Neuropribor/wec/README.md

# wec
An open-source Wireless Electrophysological Complex
