Neuropribor/wec/software/source_code_for_MouseBrainView-v0.2.3/README_rus.md

# Project 45340

## GUI
Клиент с графическим интерфейсом находится в папке GUI.  
Для его сборки необходимо следующее ПО:  
- Python 3.7
- библиотека PyQt5 5.12.3
- библиотека PyQtGraph 0.11.1
- библиотека numpy 1.19.5
- pyinstaller 4.2
- pyrcc5 5.12.3
  
Для запуска программы нужно перейти в папку "build" и выполнить команду
```
make run
```
Для сборки бинарного файла просто выполнить команду
```
make
```
Команда "make" без "run" соберёт статический бинарный файл, который можно в будущем запустить на другом компьютере без рабочего окружения.  

По-умолчанию в makefile используется команда "python3" для запуска python3 и команда "pyrcc5" для запуска pyrcc5.  
Если в вашем рабочем окружении ключевые слова для вызова этих программ отличаются, можно задать другие ключевые слова для python3 и pyrcc5 при помощи переменных среды PP3 и RCC5 соответственно.  
Пример:
```
C:\msys64\usr\bin\make PP3=python RCC5=C:\Users\owner\anaconda3\Library\bin\pyrcc5.bat run
```
