Neuropribor/wec/BOM/base_station/base_station.xls

Comment | Designator | Footprint | LCSC
KH-5220-A56 | AE1 | 5.2x2.0mm | C504003
CL10A105KB8NNNC | C14,C19,C35 | Capacitor_SMD:C_0603_1608Metric | C15849
CL10A225KO8NNNC | C21,C23 | Capacitor_SMD:C_0603_1608Metric | C23630
1206B103K202NT | C3,C4 | Capacitor_SMD:C_1206_3216Metric | C53737
CL10B333KB8NNNC | C30 | Capacitor_SMD:C_0603_1608Metric | C21117
CL10B102KB8NNNC | C31 | Capacitor_SMD:C_0603_1608Metric | C1588
0603B103K500NT | C33 | Capacitor_SMD:C_0603_1608Metric | C57112
0603B222K500NT | C36 | Capacitor_SMD:C_0603_1608Metric | C1604
0603CG1R5C500NT | C37 | Capacitor_SMD:C_0603_1608Metric | C1639
0603CG4R7C500NT | C38 | Capacitor_SMD:C_0603_1608Metric | C1669
CL10C010CB8NNNC | C39 | Capacitor_SMD:C_0603_1608Metric | C23969
CC0603KRX7R9BB104 | C1,C2,C5,C6,C7,C8,C10,C12,C13,C15,C16,C17,C20,C24,C25,C26,C27,C28,C29 | Capacitor_SMD:C_0603_1608Metric | C14663
CL10C220JB8NNNC | C9,C11,C18,C22,C32,C34 | Capacitor_SMD:C_0603_1608Metric | C1653
DM9162EP | D1 | Package_QFP:LQFP-48_7x7mm_P0.5mm | C692729
LY68L6400 | D2 | Package_SO:SO-8_3.9x4.9mm_P1.27mm | C261881
SDCL1608C8N2JTDF | L1 | Inductor_SMD:L_0603_1608Metric | C1032
SDCL1608C3N9STDF | L2 | Inductor_SMD:L_0603_1608Metric | C13818
SDCL1608C2N7STDF | L3 | Inductor_SMD:L_0603_1608Metric | C13817
0603WAF1002T5E | R1,R2,R10,R12,R13,R14,R19,R20,R27,R29,R31 | Resistor_SMD:R_0603_1608Metric | C25804
0603WAF6801T5E | R11 | Resistor_SMD:R_0603_1608Metric | C23212
0603WAF3000T5E | R15,R16,R23,R24,R25,R26,R28,R30,R32,R33,R34 | Resistor_SMD:R_0603_1608Metric | C23025
0603WAF5101T5E | R17,R18 | Resistor_SMD:R_0603_1608Metric | C23186
0603WAF2202T5E | R21 | Resistor_SMD:R_0603_1608Metric | C31850
0603WAF1004T5E | R22 | Resistor_SMD:R_0603_1608Metric | C22935
0603WAF4701T5E | R35,R36,R37 | Resistor_SMD:R_0603_1608Metric | C23162
0603WAF5100T5E | R3,R4 | Resistor_SMD:R_0603_1608Metric | C23193
0603WAF510JT5E | R5,R6,R7,R8 | Resistor_SMD:R_0603_1608Metric | C23197
0603WAF0000T5E | R9 | Resistor_SMD:R_0603_1608Metric | C21189
AMS1117-3.3 | U1 | Package_TO_SOT_SMD:SOT-223-3_TabPin2 | C6186
SST25VF040B-50-4I-S2AF | U2 | Package_SO:SOIC-8_5.275x5.275mm_P1.27mm | C178274
STM32F746VET6 | U3 | Package_QFP:LQFP-100_14x14mm_P0.5mm | C117505
NRF24L01P-R | U4 | Package_DFN_QFN:QFN-20-1EP_4x4mm_P0.5mm_EP2.5x2.5mm | C8791
TLP172GM | U5,U6,U7 | Package_SO:MFSOP6-4_4.4x3.6mm_P1.27mm | C261926
TP4054 | U8,U9,U10 | Package_TO_SOT_SMD:TSOT-23-5 | C32574
X322525MOB4SI | Y1 | Crystal:Crystal_SMD_3225-4Pin_3.2x2.5mm | C9006
X322516MLB4SI | Y2,Y3 | Crystal:Crystal_SMD_3225-4Pin_3.2x2.5mm | C13738
