Neuropribor/wec/BOM/wireless_module/wireless_module_BOM.xls

Comment | Designator | Footprint | LCSC | Contacts
KH-5220-A56 | AE1 | Resistor_SMD:R_2010_5025Metric_Pad1.52x2.65mm_HandSolder | C504003 | https://lcsc.com/
0402CG4R7C500NT | C10 | Capacitor_SMD:C_0402_1005Metric | C1569 | https://lcsc.com/
0402CG1R0C500NT | C11 | Capacitor_SMD:C_0402_1005Metric | C1550 | https://lcsc.com/
CL05B104KO5NNNC | C14 | Capacitor_SMD:C_0402_1005Metric | C1525 | https://lcsc.com/
CL05A105KA5NQNC | C2,C13 | Capacitor_SMD:C_0402_1005Metric | C52923 | https://lcsc.com/
CL05B103KB5NNNC | C3,C15 | Capacitor_SMD:C_0402_1005Metric | C15195 | https://lcsc.com/
0402B102K500NT | C1,C4,C12 | Capacitor_SMD:C_0402_1005Metric | C1523 | https://lcsc.com/
0402F333M500NT | C5 | Capacitor_SMD:C_0402_1005Metric | C1585 | https://lcsc.com/
0402CG220J500NT | C6,C7 | Capacitor_SMD:C_0402_1005Metric | C1555 | https://lcsc.com/
0402B222K500NT | C8 | Capacitor_SMD:C_0402_1005Metric | C1531 | https://lcsc.com/
0402CG1R5C500NT | C9 | Capacitor_SMD:C_0402_1005Metric | C1552 | https://lcsc.com/
RHD2132 | D1 | Package_DFN_QFN:QFN-56-1EP_8x8mm_P0.5mm_EP4.5x5.2mm |  | http://intantech.com/products_RHD2000.html
STM32G071GBU6 | D2 | STM32F031G4U6:QFN50P400X400X60-28N | C529347 | https://lcsc.com/
FC-F1005YGK-572J5 | D3 | LED_SMD:LED_0402_1005Metric | C130722 | https://lcsc.com/
A79027-001 | J1 | main_block:A79027-001 |  | https://www.cseonline.com.au/A79027-001.html
A79607-001 | J5 | main_block:A79607-001 |  | https://www.cseonline.com.au/A79607-001.html
SDCL1005C8N2JTDF | L1 | Inductor_SMD:L_0402_1005Metric | C16208 | https://lcsc.com/
SDCL1005C3N9STDF | L2 | Inductor_SMD:L_0402_1005Metric | C14033 | https://lcsc.com/
SDCL1005C2N7STDF | L3 | Inductor_SMD:L_0402_1005Metric | C27123 | https://lcsc.com/
0402WGF1002TCE | R1 | Resistor_SMD:R_0402_1005Metric | C25744 | https://lcsc.com/
0402WGF2202TCE | R2 | Resistor_SMD:R_0402_1005Metric | C25768 | https://lcsc.com/
0402WGF1004TCE | R3 | Resistor_SMD:R_0402_1005Metric | C26083 | https://lcsc.com/
0402WGF3300TCE | R4,R5,R6,R7 | Resistor_SMD:R_0402_1005Metric | C25104 | https://lcsc.com/
KTH1601SL-ST3 | U1 | Package_TO_SOT_SMD:SOT-23 | C516265 | https://lcsc.com/
TLV70033DSER | U2,U3 | Package_SON:WSON-6_1.5x1.5mm_P0.5mm | C97256 | https://lcsc.com/
nRF24L01P | U4 | Package_DFN_QFN:QFN-20-1EP_4x4mm_P0.5mm_EP2.5x2.5mm | C8791 | https://lcsc.com/
7F16000E12UCG | Y1 | Crystal:Crystal_SMD_2016-4Pin_2.0x1.6mm | C252270 | https://lcsc.com/
