Neuropribor/wec/firmware/source_code_for_firmware_STM32CubeIDE/wireless_module/main_block/step/dg_main_block.step

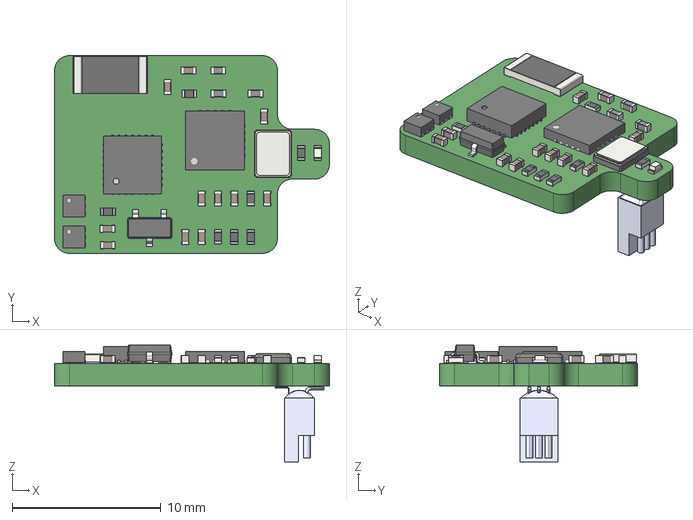
[picture p1: CAD file, 2021-10-13]
firmware/source_code_for_firmware_STM32CubeIDE/wireless_module/main_block/step/dg_main_block.step
18.5 x 13.3 x 7.87 mm
