Neuropribor/wec/3d_models/base_chargin_station/wireless_module_mount_X3.STL

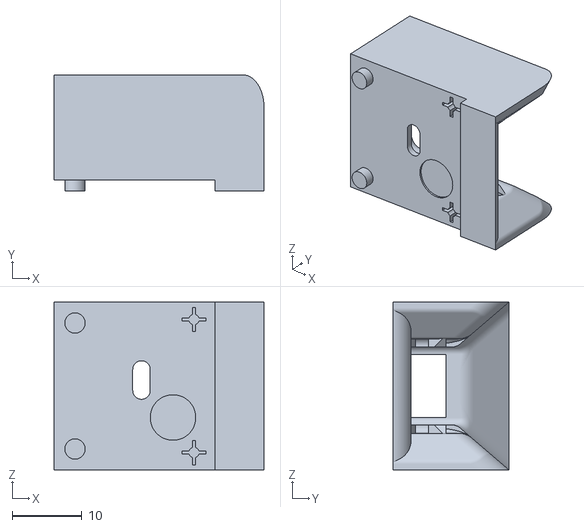
[picture p2: CAD file, 2021-10-13]
3d_models/base_chargin_station/wireless_module_mount_X3.STL
30.0 x 16.6 x 24.0
