Neuropribor/wec/3d_models/wireless_module_clip/bottom.STL

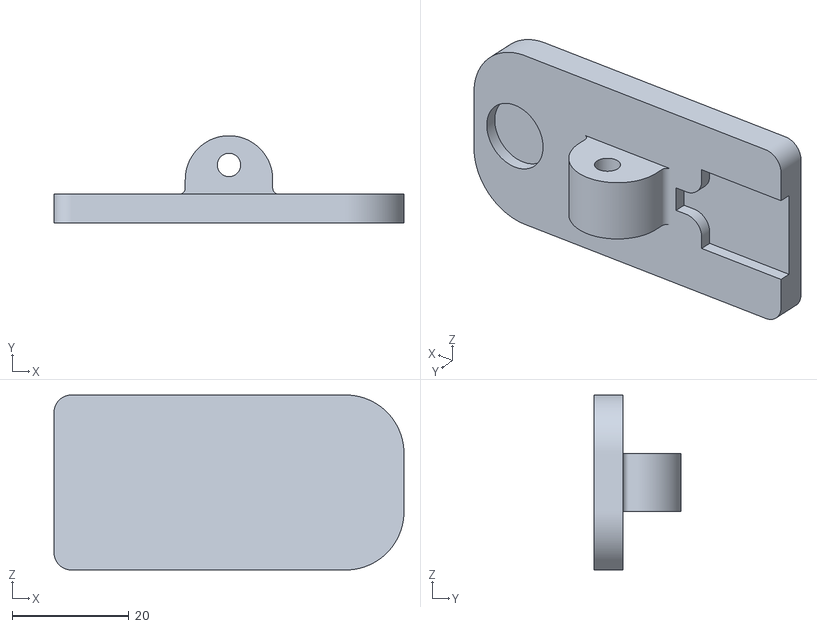
[picture p3: CAD file, 2021-10-13]
3d_models/wireless_module_clip/bottom.STL
60.0 x 15.0 x 30.0
