Neuropribor/wec/3d_models/base_chargin_station/bottom_cover.STL

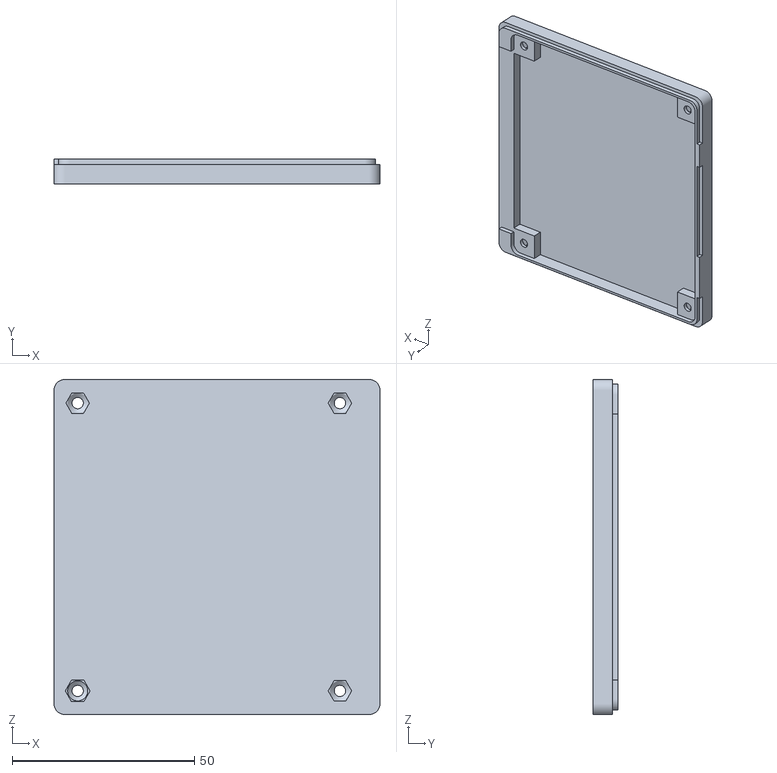
[picture p4: CAD file, 2021-10-13]
3d_models/base_chargin_station/bottom_cover.STL
89.5 x 7.00 x 92.0
