Neuropribor/wec/3d_models/wireless_module_clip/top.STL

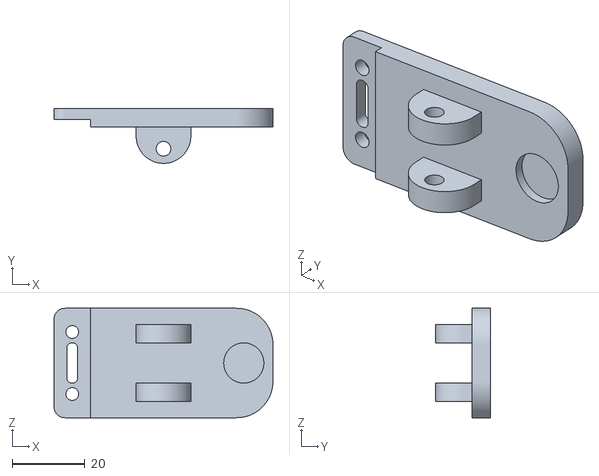
[picture p5: CAD file, 2021-10-13]
3d_models/wireless_module_clip/top.STL
60.0 x 15.0 x 30.0
