Neuropribor/wec/3d_models/base_chargin_station/LED_holder.STL

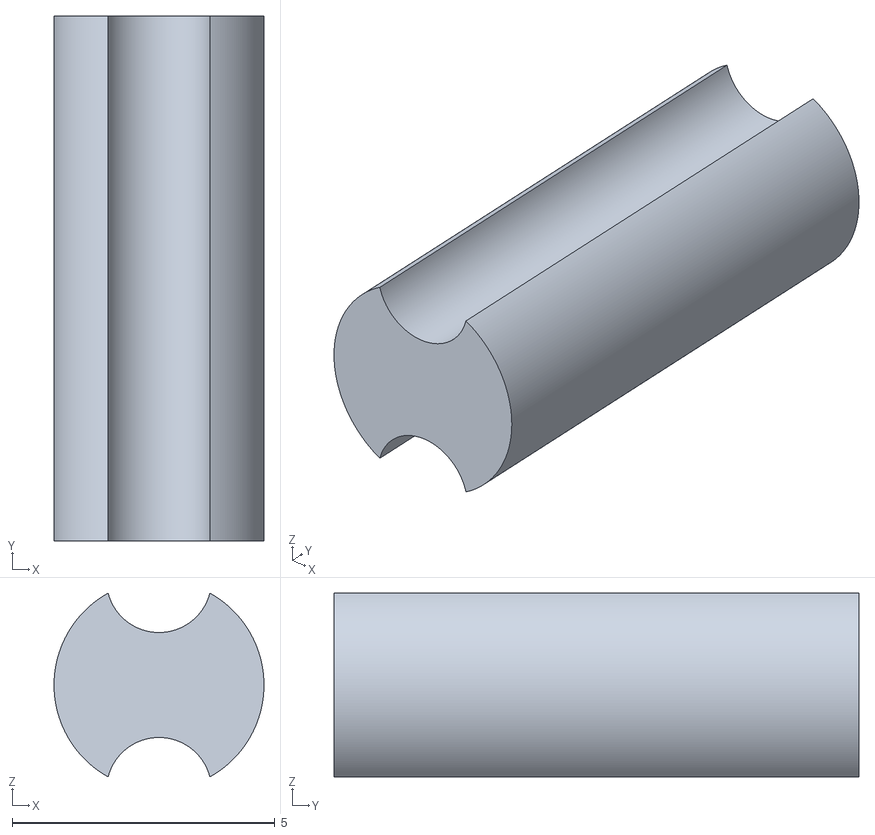
[picture p6: CAD file, 2021-10-13]
3d_models/base_chargin_station/LED_holder.STL
4.00 x 10.0 x 3.50
