Neuropribor/wec/firmware/source_code_for_firmware_STM32CubeIDE/base_station/charge_block/charge_block.pdf

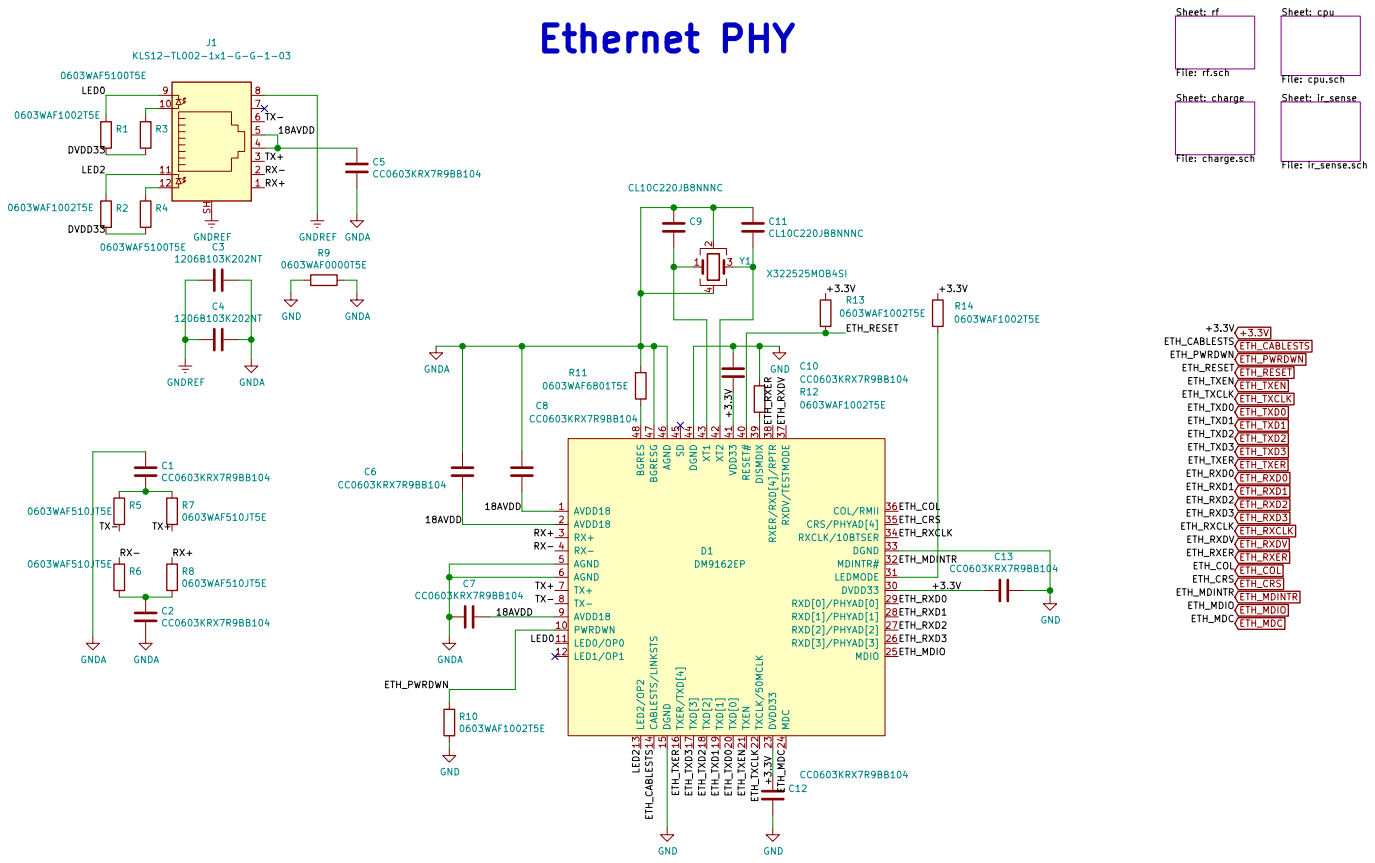
[picture p7: page 1]

File: charge.sch Sheet: rf File: rf.sch C4

Sheet: ir_sense File: ir_sense.sch Sheet: cpu
