Neuropribor/wec/firmware/source_code_for_firmware_STM32CubeIDE/base_station/charge_block/cpu-cpu.pdf

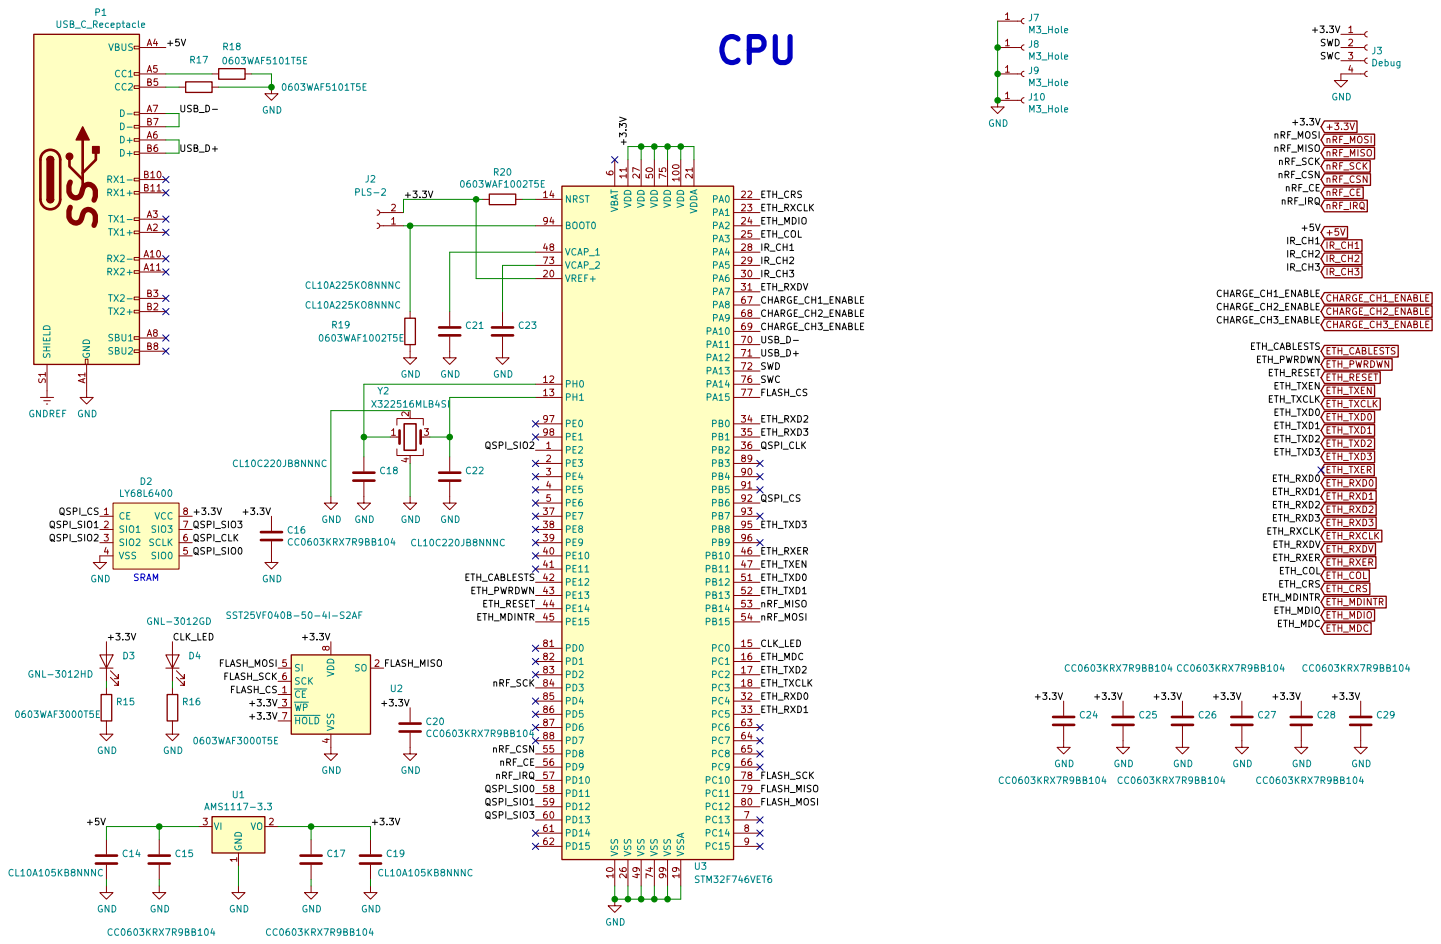
[picture p8: page 1]

6 VCAP_1 48 VCAP_2 73 VDD 100 VDD 11 VDD 27 VDD 50 VDD 75 VDDA 21 VREF+ 20 VSS 10 VSS 26 VSS 49 VSS 74 VSS 99 VSSA 19U3STM32F746VET6 GND GND

4 SI 5 SCK 6 HOLD 7 VDD
