Neuropribor/wec/firmware/source_code_for_firmware_STM32CubeIDE/base_station/charge_block/rf-rf.pdf

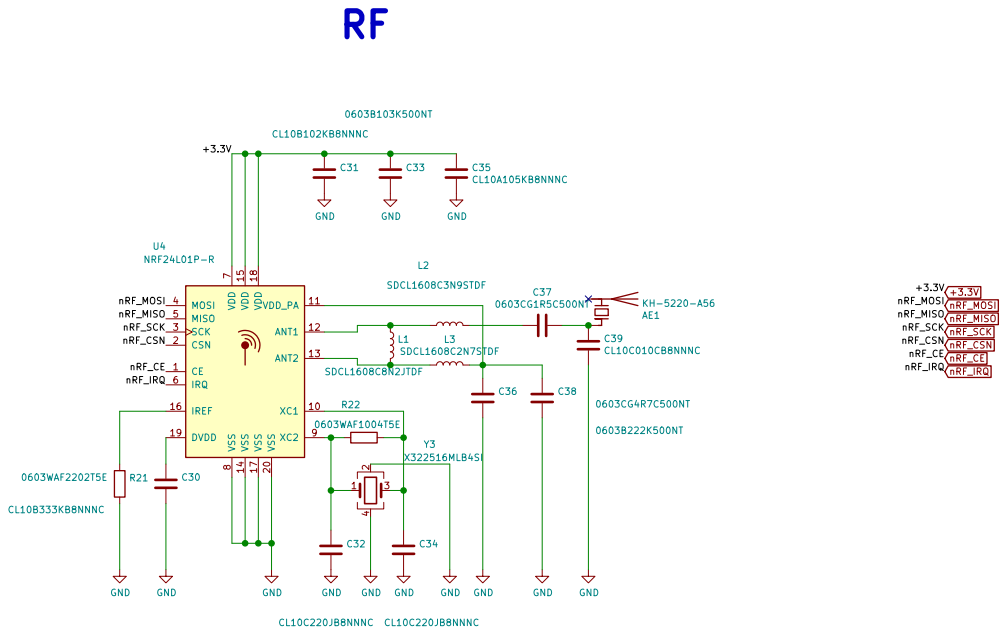
[picture p9: page 1]

4 Y3 X322516MLB4SI GND GND GND GND GND
