Neuropribor/wec/firmware/source_code_for_firmware_STM32CubeIDE/base_station/charge_block/charge-charge.pdf

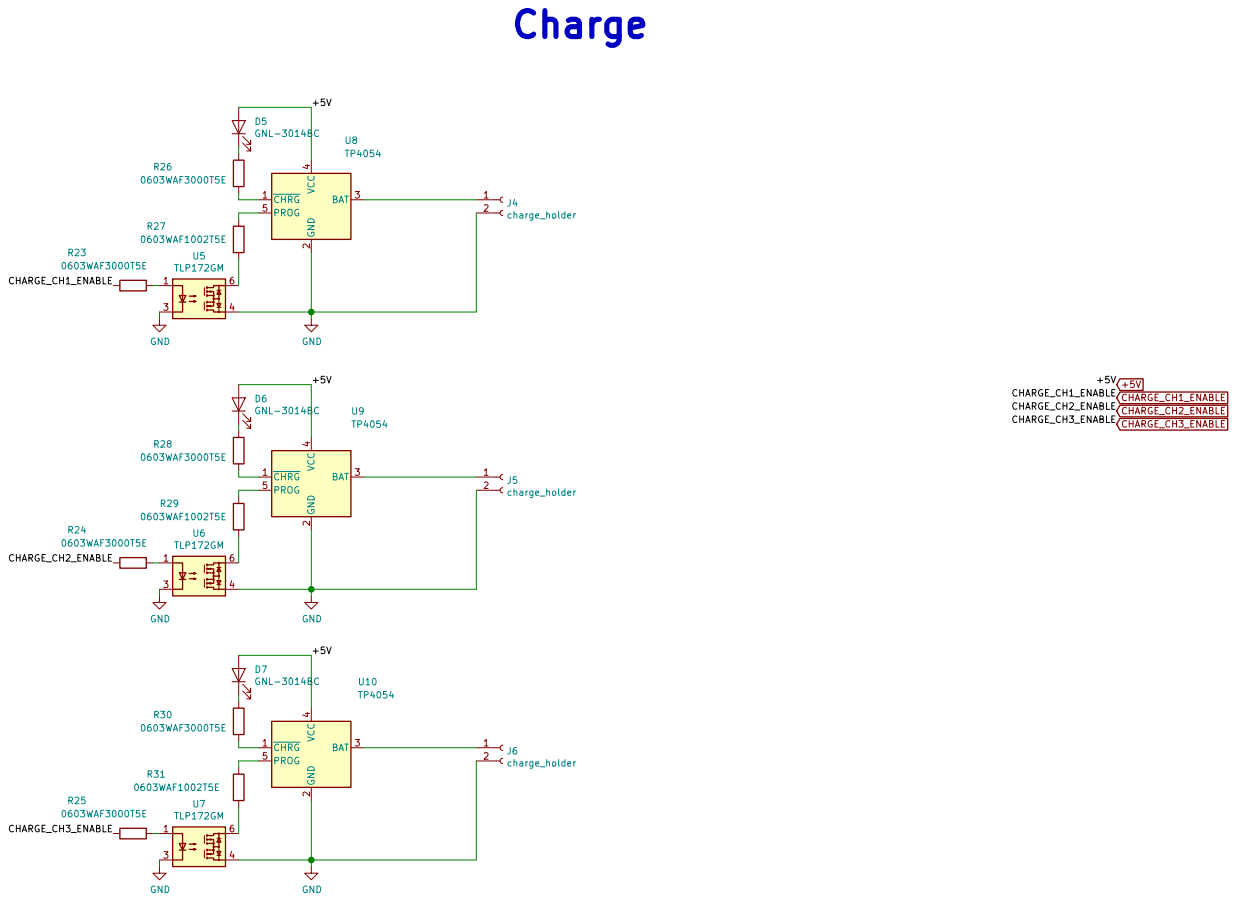
[picture p10: page 1]
