Neuropribor/wec/firmware/source_code_for_firmware_STM32CubeIDE/base_station/charge_block/ir_sense-ir_sense.pdf

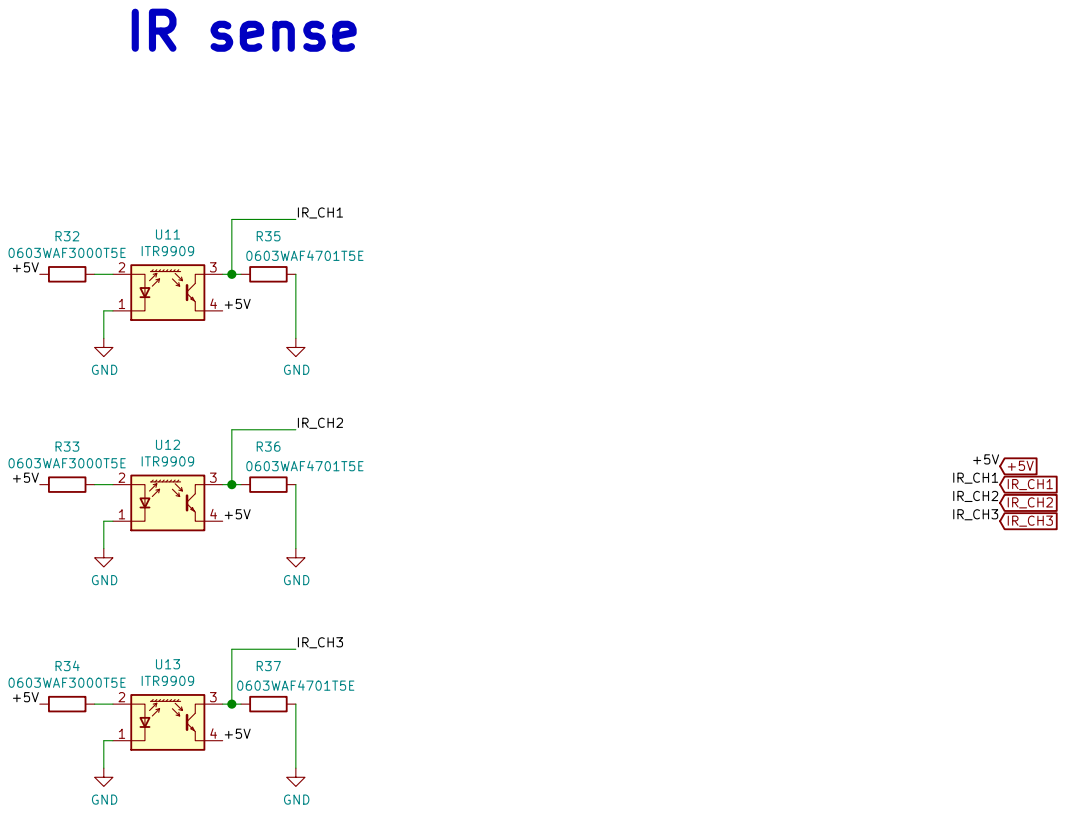
[picture p11: page 1]
