Neuropribor/wec/firmware/source_code_for_firmware_STM32CubeIDE/wireless_module/main_block/main_block.kicad_pcb

## KiCad design firmware/source_code_for_firmware_STM32CubeIDE/wireless_module/main_block/main_block.kicad_pcb (2021-10-13)

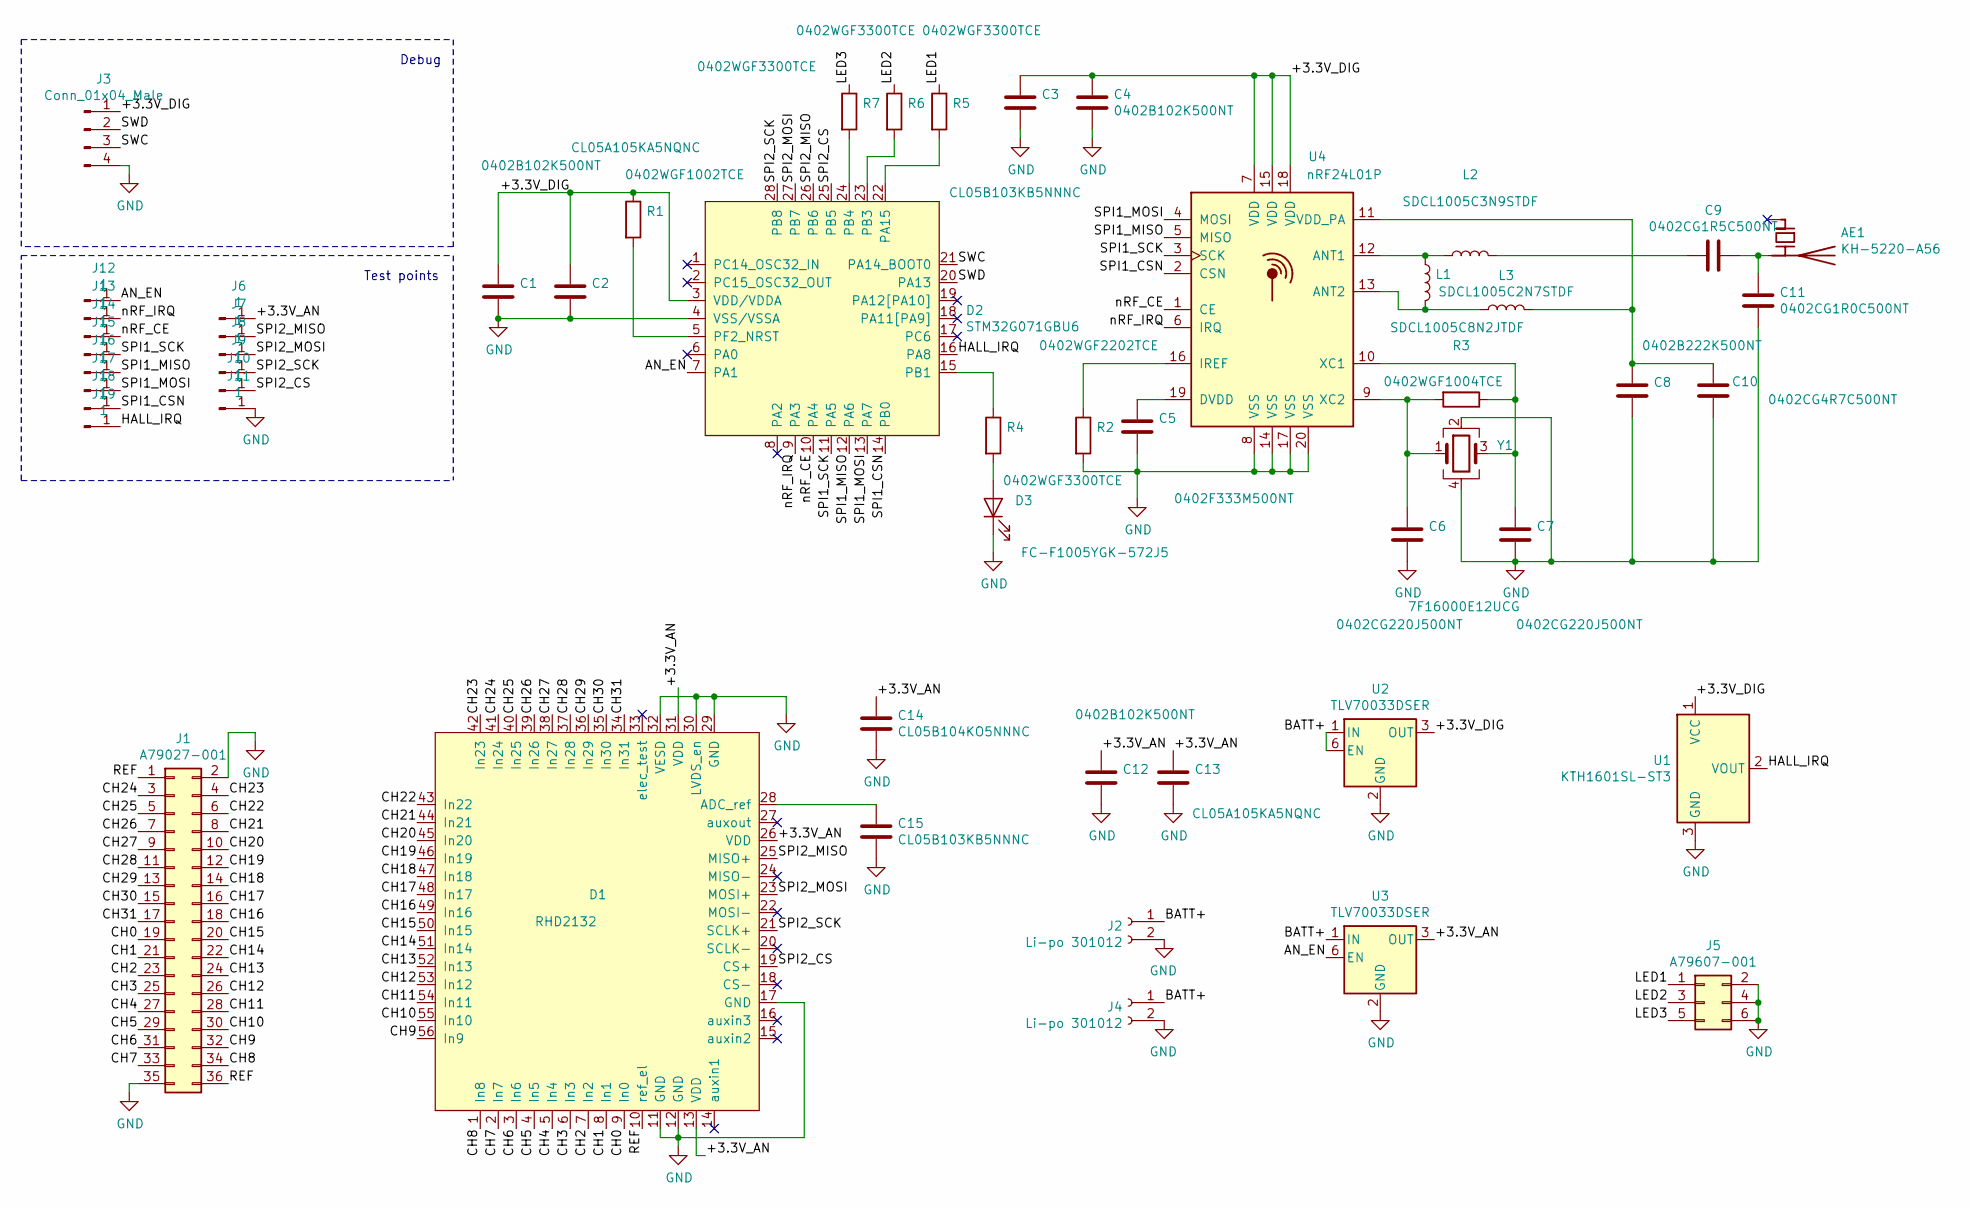
[picture p12: schematic main_block.sch]

Parts:
AE1: KH-5220-A56; R_2010_5025Metric_Pad1.52x2.65mm_HandSolder; LCSC C504003
C1, C4, C12: 0402B102K500NT; C_0402_1005Metric; LCSC C1523
C2, C13: CL05A105KA5NQNC; C_0402_1005Metric; LCSC C52923
C3, C15: CL05B103KB5NNNC; C_0402_1005Metric; LCSC C15195
C5: 0402F333M500NT; C_0402_1005Metric; LCSC C1585
C6, C7: 0402CG220J500NT; C_0402_1005Metric; LCSC C1555
C8: 0402B222K500NT; C_0402_1005Metric; LCSC C1531
C9: 0402CG1R5C500NT; C_0402_1005Metric; LCSC C1552
C10: 0402CG4R7C500NT; C_0402_1005Metric; LCSC C1569
C11: 0402CG1R0C500NT; C_0402_1005Metric; LCSC C1550
C14: CL05B104KO5NNNC; C_0402_1005Metric; LCSC C1525
D1: RHD2132; QFN-56-1EP_8x8mm_P0.5mm_EP4.5x5.2mm
D2: STM32G071GBU6; QFN50P400X400X60-28N; LCSC C529347
D3: FC-F1005YGK-572J5; LED_0402_1005Metric; LCSC C130722
J1: A79027-001
J2, J4: Li-po 301012; PinHeader_1x02_P2.00mm_Vertical
J3: Conn_01x04_Male; debug
J5: A79607-001
J6, J7, J8, J9, J10, J11, J12, J13, J14, J15, J16, J17, J18, J19: 1; debug_
L1: SDCL1005C8N2JTDF; L_0402_1005Metric; LCSC C16208
L2: SDCL1005C3N9STDF; L_0402_1005Metric; LCSC C14033
L3: SDCL1005C2N7STDF; L_0402_1005Metric; LCSC C27123
R1: 0402WGF1002TCE; R_0402_1005Metric; LCSC C25744
R2: 0402WGF2202TCE; R_0402_1005Metric; LCSC C25768
R3: 0402WGF1004TCE; R_0402_1005Metric; LCSC C26083
R4, R5, R6, R7: 0402WGF3300TCE; R_0402_1005Metric; LCSC C25104
U1: KTH1601SL-ST3; SOT-23; LCSC C516265
U2, U3: TLV70033DSER; WSON-6_1.5x1.5mm_P0.5mm; LCSC C97256
U4: nRF24L01P; QFN-20-1EP_4x4mm_P0.5mm_EP2.5x2.5mm; LCSC C8791
Y1: 7F16000E12UCG; Crystal_SMD_2016-4Pin_2.0x1.6mm; LCSC C252270

Connections:
/+3.3V_AN: C12.1, C13.1, C14.1, D1.13 (VDD), D1.26 (VDD), D1.31 (VDD), J6.1, U3.3 (OUT)
/+3.3V_DIG: C1.1, C2.1, C3.1, C4.1, D2.3 (VDD/VDDA), J3.1, R1.1, U1.1 (VCC), U2.3 (OUT), U4.7 (VDD), U4.15 (VDD), U4.18 (VDD)
/AN_EN: D2.7 (PA1), J12.1, U3.6 (EN)
/BATT+: J2.1, J4.1, U2.1 (IN), U2.6 (EN), U3.1 (IN)
/CH0: D1.9 (In0), J1.19
/CH1: D1.8 (In1), J1.21
/CH2: D1.7 (In2), J1.23
/CH3: D1.6 (In3), J1.25
/CH4: D1.5 (In4), J1.27
/CH5: D1.4 (In5), J1.29
/CH6: D1.3 (In6), J1.31
/CH7: D1.2 (In7), J1.33
/CH8: D1.1 (In8), J1.34
/CH9: D1.56 (In9), J1.32
/CH10: D1.55 (In10), J1.30
/CH11: D1.54 (In11), J1.28
/CH12: D1.53 (In12), J1.26
/CH13: D1.52 (In13), J1.24
/CH14: D1.51 (In14), J1.22
/CH15: D1.50 (In15), J1.20
/CH16: D1.49 (In16), J1.18
/CH17: D1.48 (In17), J1.16
/CH18: D1.47 (In18), J1.14
/CH19: D1.46 (In19), J1.12
/CH20: D1.45 (In20), J1.10
/CH21: D1.44 (In21), J1.8
/CH22: D1.43 (In22), J1.6
/CH23: D1.42 (In23), J1.4
/CH24: D1.41 (In24), J1.3
/CH25: D1.40 (In25), J1.5
/CH26: D1.39 (In26), J1.7
/CH27: D1.38 (In27), J1.9
/CH28: D1.37 (In28), J1.11
/CH29: D1.36 (In29), J1.13
/CH30: D1.35 (In30), J1.15
/CH31: D1.34 (In31), J1.17
/HALL_IRQ: D2.16 (PA8), J19.1, U1.2 (VOUT)
/LED1: J5.1, R5.1
/LED2: J5.3, R6.1
/LED3: J5.5, R7.1
/REF: D1.10 (ref_el), J1.1, J1.36
/SPI1_CSN: D2.14 (PB0), J18.1, U4.2 (CSN)
/SPI1_MISO: D2.12 (PA6), J16.1, U4.5 (MISO)
/SPI1_MOSI: D2.13 (PA7), J17.1, U4.4 (MOSI)
/SPI1_SCK: D2.11 (PA5), J15.1, U4.3 (SCK)
/SPI2_CS: D1.19 (CS+), D2.25 (PB5), J10.1
/SPI2_MISO: D1.25 (MISO+), D2.26 (PB6), J7.1
/SPI2_MOSI: D1.23 (MOSI+), D2.27 (PB7), J8.1
/SPI2_SCK: D1.21 (SCLK+), D2.28 (PB8), J9.1
/SWC: D2.21 (PA14_BOOT0), J3.3
/SWD: D2.20 (PA13), J3.2
/nRF_CE: D2.10 (PA4), J14.1, U4.1 (CE)
/nRF_IRQ: D2.9 (PA3), J13.1, U4.6 (IRQ)
GND: C1.2, C2.2, C3.2, C4.2, C5.2, C6.2, C7.2, C8.2, C10.2, C11.2, C12.2, C13.2, C14.2, C15.2, D1.11 (GND), D1.12 (GND), D1.17 (GND), D1.29 (GND), D1.30 (LVDS_en), D1.32 (VESD), D2.4 (VSS/VSSA), D3.1 (K), J1.2, J1.35, J2.2, J3.4, J4.2, J5.2, J5.4, J5.6, J11.1, R2.2, U1.3 (GND), U2.2 (GND), U3.2 (GND), U4.8 (VSS), U4.14 (VSS), U4.17 (VSS), U4.20 (VSS), Y1.2, Y1.4
unnamed: AE1.2 (PCB_Trace), C9.1, C11.1
unnamed: C5.1, U4.19 (DVDD)
unnamed: C6.1, R3.2, U4.9 (XC2), Y1.1
unnamed: C7.1, R3.1, U4.10 (XC1), Y1.3
unnamed: C9.2, L2.2
unnamed: C8.1, C10.1, L3.2, U4.11 (VDD_PA)
unnamed: C15.1, D1.28 (ADC_ref)
unnamed: D2.5 (PF2_NRST), R1.2
unnamed: D2.15 (PB1), R4.1
unnamed: D2.22 (PA15), R5.2
unnamed: D2.23 (PB3), R6.2
unnamed: D2.24 (PB4), R7.2
unnamed: D3.2 (A), R4.2
unnamed: L1.1, L2.1, U4.12 (ANT1)
unnamed: L1.2, L3.1, U4.13 (ANT2)
unnamed: R2.1, U4.16 (IREF)

Notes on the sheet:
Test points
Debug

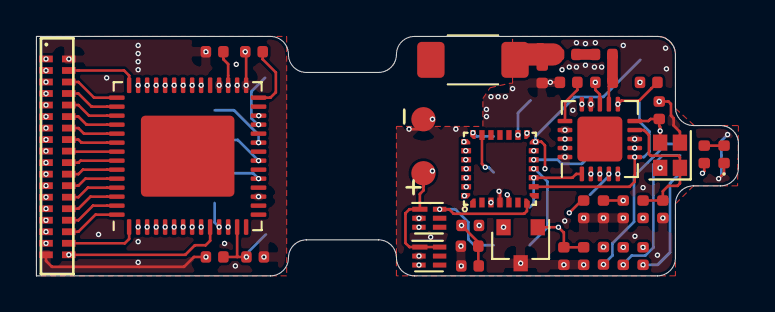
[picture p13: board main_block.kicad_pcb from above]

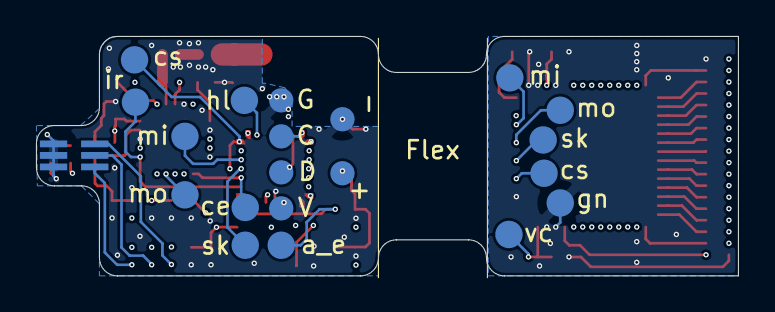
[picture p14: board main_block.kicad_pcb from below]

Board: 4 copper layers, 39.0 x 13.3 mm, 53 parts (17 on the bottom side), 70 nets.
