Neuropribor/wec/firmware/source_code_for_firmware_STM32CubeIDE/base_station/charge_block/charge_block.kicad_pcb

## KiCad design firmware/source_code_for_firmware_STM32CubeIDE/base_station/charge_block/charge_block.kicad_pcb (2021-10-13)

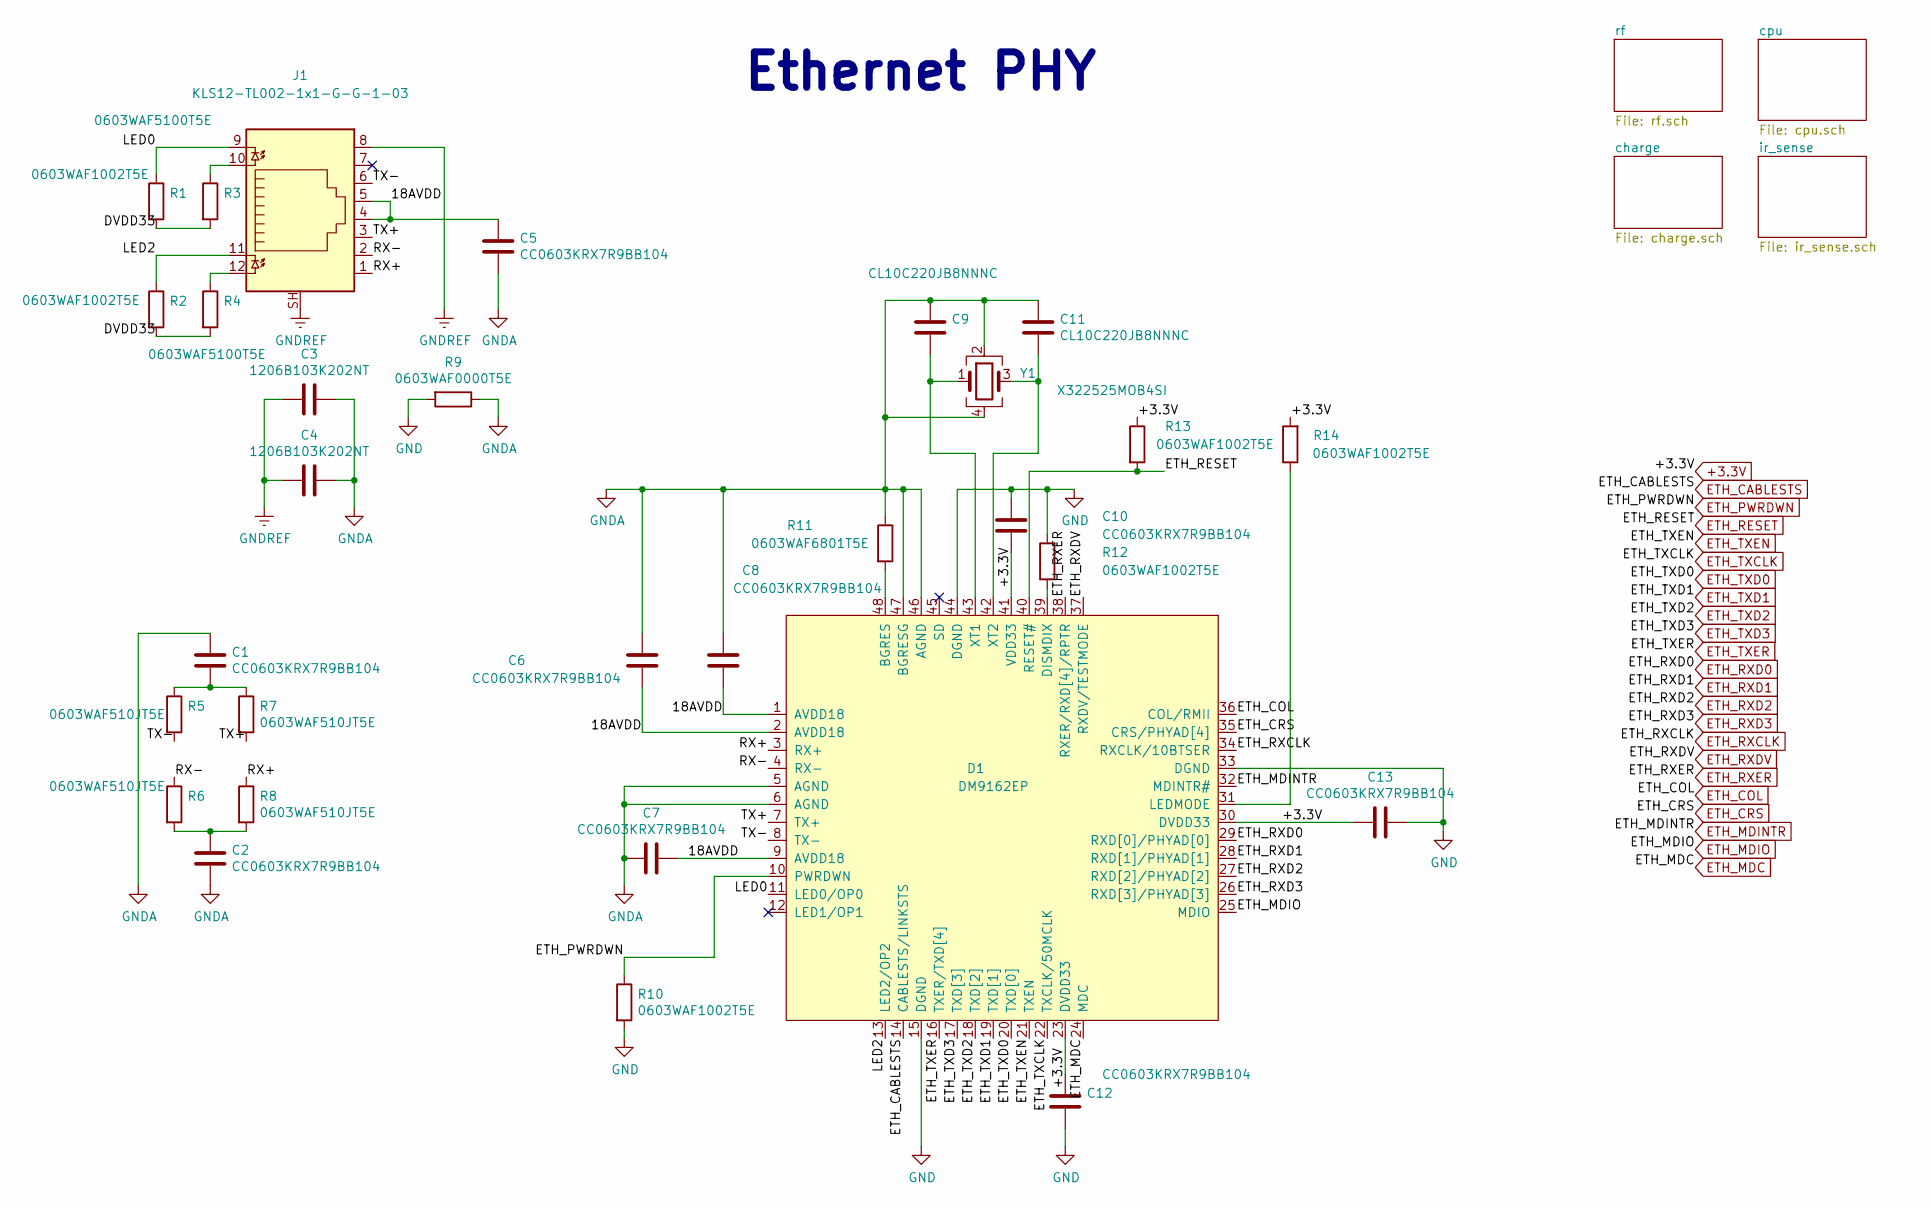
[picture p15: schematic charge_block.sch]

Parts:
C1, C2, C5, C6, C7, C8, C10, C12, C13: CC0603KRX7R9BB104; C_0603_1608Metric; LCSC C14663
C3, C4: 1206B103K202NT; C_1206_3216Metric; LCSC C53737
C9, C11: CL10C220JB8NNNC; C_0603_1608Metric; LCSC C1653
D1: DM9162EP; LQFP-48_7x7mm_P0.5mm; LCSC C692729
J1: KLS12-TL002-1x1-G-G-1-03; KLS12-TL002
R1, R2, R10, R12, R13, R14: 0603WAF1002T5E; R_0603_1608Metric; LCSC C25804
R3, R4: 0603WAF5100T5E; R_0603_1608Metric; LCSC C23193
R5, R6, R7, R8: 0603WAF510JT5E; R_0603_1608Metric; LCSC C23197
R9: 0603WAF0000T5E; R_0603_1608Metric; LCSC C21189
R11: 0603WAF6801T5E; R_0603_1608Metric; LCSC C23212
Y1: X322525MOB4SI; Crystal_SMD_3225-4Pin_3.2x2.5mm; LCSC C9006

Connections:
+3.3V: C10.2, C12.2, C13.1, D1.23 (DVDD33), D1.30 (DVDD33), D1.41 (VDD33), R13.1, R14.2; also elsewhere on the board
/18AVDD: C5.1, C6.2, C7.1, C8.2, D1.1 (AVDD18), D1.2 (AVDD18), D1.9 (AVDD18), J1.4, J1.5
/DVDD33: R1.2, R2.2, R3.2, R4.2
/LED0: D1.11 (LED0/OP0), J1.9, R1.1
/LED2: D1.13 (LED2/OP2), J1.11, R2.1
/RX+: D1.3 (RX+), J1.1, R8.1
/RX-: D1.4 (RX-), J1.2, R6.1
/TX+: D1.7 (TX+), J1.3, R7.2
/TX-: D1.8 (TX-), J1.6, R5.2
ETH_CABLESTS: D1.14 (CABLESTS/LINKSTS); also elsewhere on the board
ETH_COL: D1.36 (COL/RMII); also elsewhere on the board
ETH_CRS: D1.35 (CRS/PHYAD[4]); also elsewhere on the board
ETH_MDC: D1.24 (MDC); also elsewhere on the board
ETH_MDINTR: D1.32 (MDINTR#); also elsewhere on the board
ETH_MDIO: D1.25 (MDIO); also elsewhere on the board
ETH_PWRDWN: D1.10 (PWRDWN), R10.1; also elsewhere on the board
ETH_RESET: D1.40 (RESET#), R13.2; also elsewhere on the board
ETH_RXCLK: D1.34 (RXCLK/10BTSER); also elsewhere on the board
ETH_RXD0: D1.29 (RXD[0]/PHYAD[0]); also elsewhere on the board
ETH_RXD1: D1.28 (RXD[1]/PHYAD[1]); also elsewhere on the board
ETH_RXD2: D1.27 (RXD[2]/PHYAD[2]); also elsewhere on the board
ETH_RXD3: D1.26 (RXD[3]/PHYAD[3]); also elsewhere on the board
ETH_RXDV: D1.37 (RXDV/TESTMODE); also elsewhere on the board
ETH_RXER: D1.38 (RXER/RXD[4]/RPTR); also elsewhere on the board
ETH_TXCLK: D1.22 (TXCLK/50MCLK); also elsewhere on the board
ETH_TXD0: D1.20 (TXD[0]); also elsewhere on the board
ETH_TXD1: D1.19 (TXD[1]); also elsewhere on the board
ETH_TXD2: D1.18 (TXD[2]); also elsewhere on the board
ETH_TXD3: D1.17 (TXD[3]); also elsewhere on the board
ETH_TXEN: D1.21 (TXEN); also elsewhere on the board
ETH_TXER: D1.16 (TXER/TXD[4])
GND: C10.1, C12.1, C13.2, D1.15 (DGND), D1.33 (DGND), D1.44 (DGND), R9.2, R10.2, R12.2; also elsewhere on the board
GNDA: C1.1, C2.2, C3.1, C4.1, C5.2, C6.1, C7.2, C8.1, C9.1, C11.1, D1.5 (AGND), D1.6 (AGND), D1.46 (AGND), D1.47 (BGRESG), R9.1, R11.1, Y1.2, Y1.4
GNDREF: C3.2, C4.2, J1.8, J1.SH; also elsewhere on the board
unnamed: C1.2, R5.1, R7.1
unnamed: C2.1, R6.2, R8.2
unnamed: C9.2, D1.43 (XT1), Y1.1
unnamed: C11.2, D1.42 (XT2), Y1.3
unnamed: D1.31 (LEDMODE), R14.1
unnamed: D1.39 (DISMDIX), R12.1
unnamed: D1.48 (BGRES), R11.2
unnamed: J1.10, R3.1
unnamed: J1.12, R4.1

Notes on the sheet:
Ethernet PHY

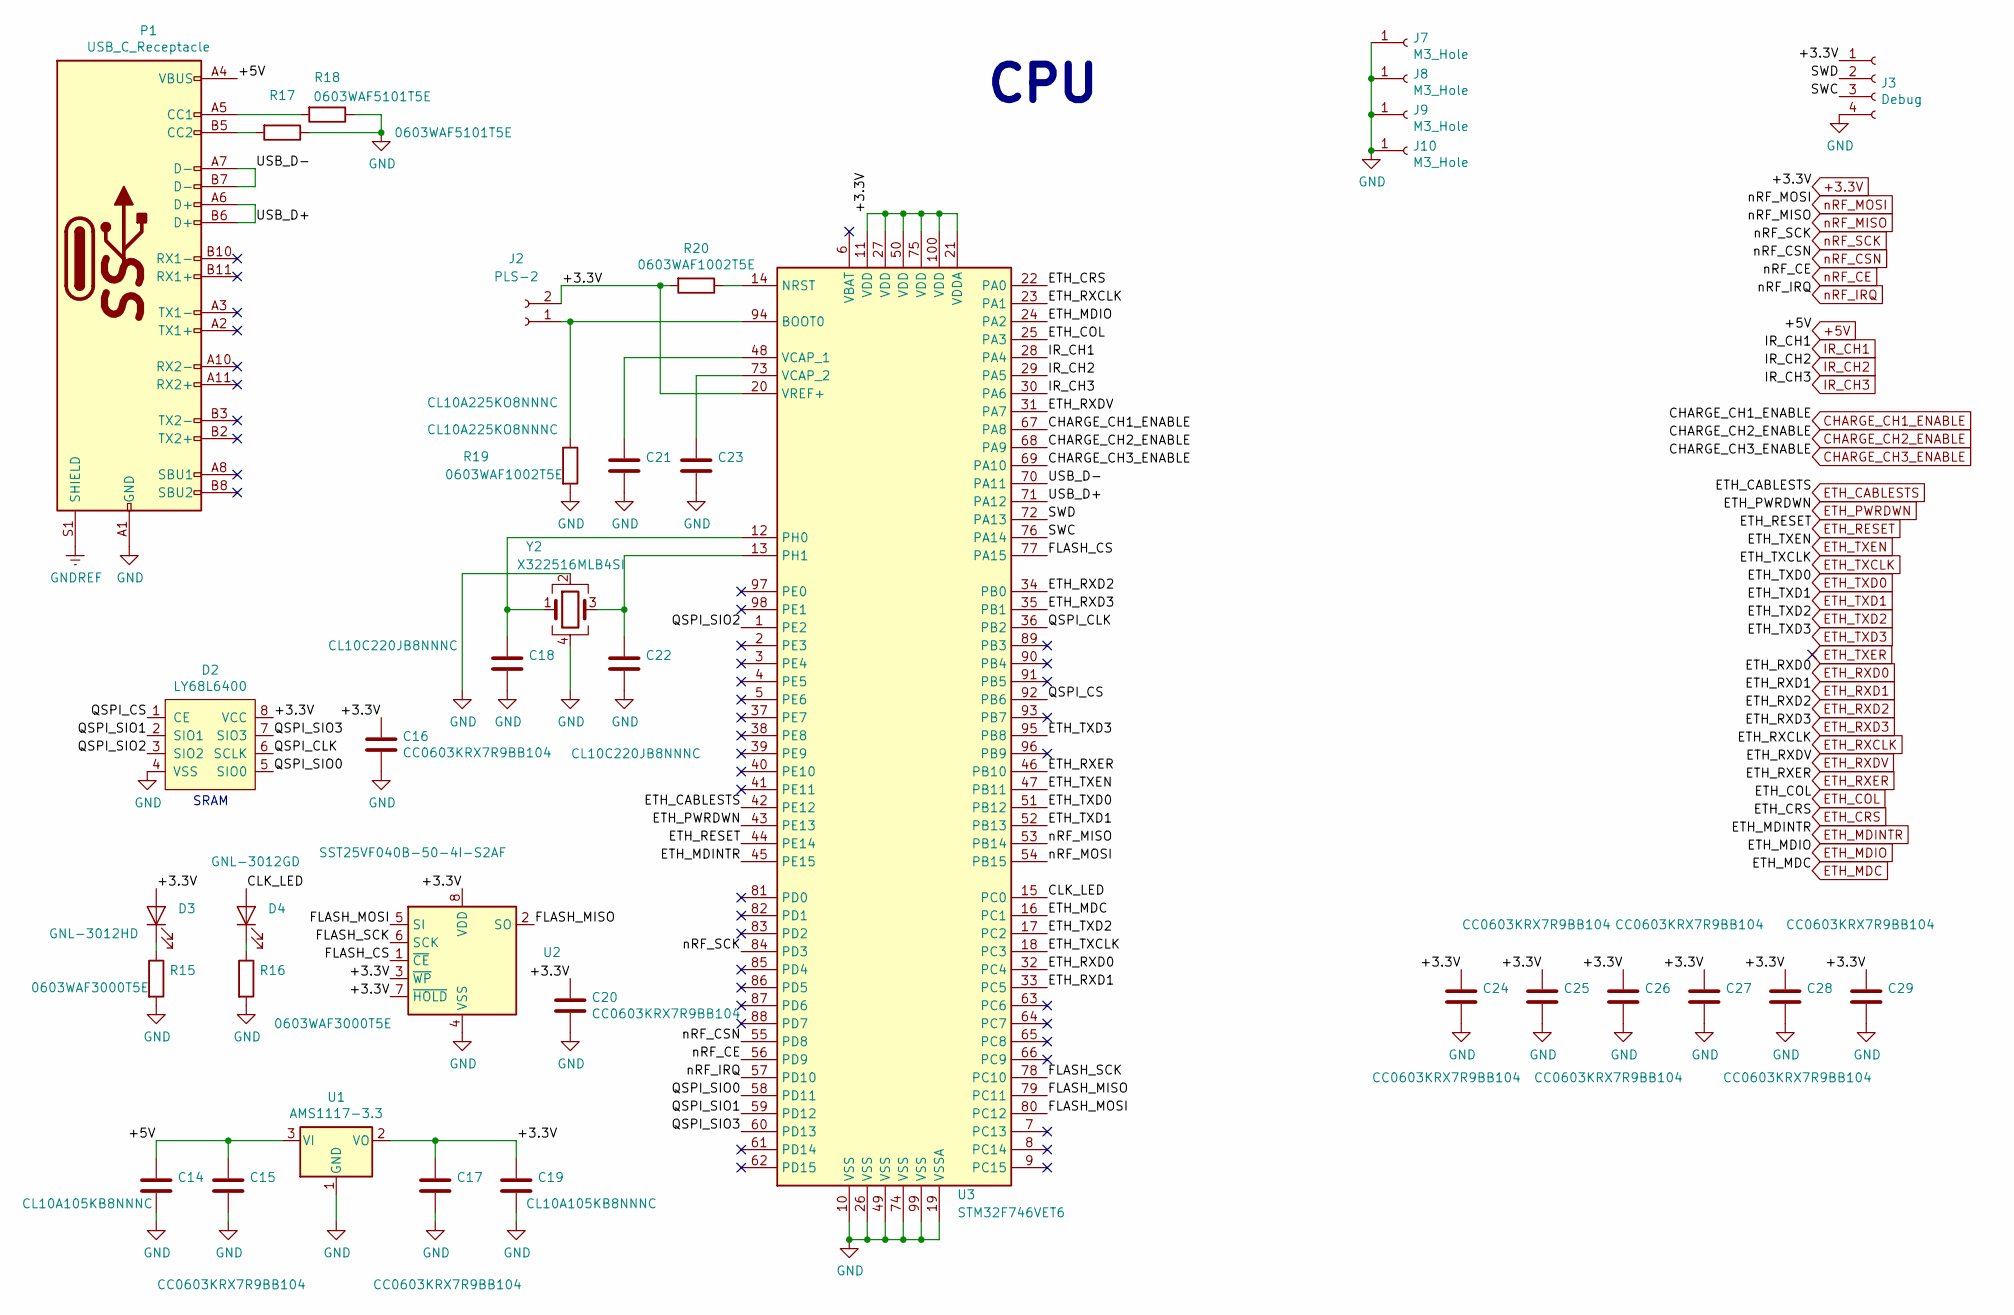
[picture p16: schematic cpu.sch]

Parts:
C14, C19: CL10A105KB8NNNC; C_0603_1608Metric; LCSC C15849
C15, C16, C17, C20, C24, C25, C26, C27, C28, C29: CC0603KRX7R9BB104; C_0603_1608Metric; LCSC C14663
C18, C22: CL10C220JB8NNNC; C_0603_1608Metric; LCSC C1653
C21, C23: CL10A225KO8NNNC; C_0603_1608Metric; LCSC C23630
D2: LY68L6400; SO-8_3.9x4.9mm_P1.27mm; LCSC C261881
D3: GNL-3012HD; LED_D3.0mm
D4: GNL-3012GD; LED_D3.0mm
J2: PLS-2; PinHeader_1x02_P2.54mm_Vertical
J3: Debug; PinHeader_1x04_P2.54mm_Vertical
J7, J8, J9, J10: M3_Hole; MountingHole_3.2mm_M3
P1: USB_C_Receptacle; USB_C_16_pin
R15, R16: 0603WAF3000T5E; R_0603_1608Metric; LCSC C23025
R17, R18: 0603WAF5101T5E; R_0603_1608Metric; LCSC C23186
R19, R20: 0603WAF1002T5E; R_0603_1608Metric; LCSC C25804
U1: AMS1117-3.3; SOT-223-3_TabPin2; LCSC C6186
U2: SST25VF040B-50-4I-S2AF; SOIC-8_5.275x5.275mm_P1.27mm; LCSC C178274
U3: STM32F746VET6; LQFP-100_14x14mm_P0.5mm; LCSC C117505
Y2: X322516MLB4SI; Crystal_SMD_3225-4Pin_3.2x2.5mm; LCSC C13738

Connections:
+3.3V: C16.1, C17.1, C19.1, C20.1, C24.1, C25.1, C26.1, C27.1, C28.1, C29.1, D2.8 (VCC), D3.2 (A), J2.2, J3.1, R20.2, U1.2 (VO), U2.3 (~WP~), U2.7 (~HOLD~), U2.8 (VDD), U3.11 (VDD), U3.20 (VREF+), U3.21 (VDDA), U3.27 (VDD), U3.50 (VDD), U3.75 (VDD), U3.100 (VDD); also elsewhere on the board
+5V: C14.1, C15.1, P1.A4 (VBUS), P1.A9 (VBUS), P1.B4 (VBUS), P1.B9 (VBUS), U1.3 (VI); also elsewhere on the board
/cpu/CLK_LED: D4.2 (A), U3.15 (PC0)
/cpu/FLASH_CS: U2.1 (~CE), U3.77 (PA15)
/cpu/FLASH_MISO: U2.2 (SO), U3.79 (PC11)
/cpu/FLASH_MOSI: U2.5 (SI), U3.80 (PC12)
/cpu/FLASH_SCK: U2.6 (SCK), U3.78 (PC10)
/cpu/QSPI_CLK: D2.6 (SCLK), U3.36 (PB2)
/cpu/QSPI_CS: D2.1 (CE), U3.92 (PB6)
/cpu/QSPI_SIO0: D2.5 (SIO0), U3.58 (PD11)
/cpu/QSPI_SIO1: D2.2 (SIO1), U3.59 (PD12)
/cpu/QSPI_SIO2: D2.3 (SIO2), U3.1 (PE2)
/cpu/QSPI_SIO3: D2.7 (SIO3), U3.60 (PD13)
/cpu/SWC: J3.3, U3.76 (PA14)
/cpu/SWD: J3.2, U3.72 (PA13)
/cpu/USB_D+: P1.A6 (D+), P1.B6 (D+), U3.71 (PA12)
/cpu/USB_D-: P1.A7 (D-), P1.B7 (D-), U3.70 (PA11)
CHARGE_CH1_ENABLE: U3.67 (PA8); also elsewhere on the board
CHARGE_CH2_ENABLE: U3.68 (PA9); also elsewhere on the board
CHARGE_CH3_ENABLE: U3.69 (PA10); also elsewhere on the board
ETH_CABLESTS: U3.42 (PE12); also elsewhere on the board
ETH_COL: U3.25 (PA3); also elsewhere on the board
ETH_CRS: U3.22 (PA0); also elsewhere on the board
ETH_MDC: U3.16 (PC1); also elsewhere on the board
ETH_MDINTR: U3.45 (PE15); also elsewhere on the board
ETH_MDIO: U3.24 (PA2); also elsewhere on the board
ETH_PWRDWN: U3.43 (PE13); also elsewhere on the board
ETH_RESET: U3.44 (PE14); also elsewhere on the board
ETH_RXCLK: U3.23 (PA1); also elsewhere on the board
ETH_RXD0: U3.32 (PC4); also elsewhere on the board
ETH_RXD1: U3.33 (PC5); also elsewhere on the board
ETH_RXD2: U3.34 (PB0); also elsewhere on the board
ETH_RXD3: U3.35 (PB1); also elsewhere on the board
ETH_RXDV: U3.31 (PA7); also elsewhere on the board
ETH_RXER: U3.46 (PB10); also elsewhere on the board
ETH_TXCLK: U3.18 (PC3); also elsewhere on the board
ETH_TXD0: U3.51 (PB12); also elsewhere on the board
ETH_TXD1: U3.52 (PB13); also elsewhere on the board
ETH_TXD2: U3.17 (PC2); also elsewhere on the board
ETH_TXD3: U3.95 (PB8); also elsewhere on the board
ETH_TXEN: U3.47 (PB11); also elsewhere on the board
GND: C14.2, C15.2, C16.2, C17.2, C18.2, C19.2, C20.2, C21.2, C22.2, C23.2, C24.2, C25.2, C26.2, C27.2, C28.2, C29.2, D2.4 (VSS), J3.4, J7.1, J8.1, J9.1, J10.1, P1.A1 (GND), P1.A12 (GND), P1.B1 (GND), P1.B12 (GND), R15.2, R16.2, R17.1, R18.1, R19.2, U1.1 (GND), U2.4 (VSS), U3.10 (VSS), U3.19 (VSSA), U3.26 (VSS), U3.49 (VSS), U3.74 (VSS), U3.99 (VSS), Y2.2, Y2.4; also elsewhere on the board
GNDREF: P1.S1 (SHIELD); also elsewhere on the board
IR_CH1: U3.28 (PA4); also elsewhere on the board
IR_CH2: U3.29 (PA5); also elsewhere on the board
IR_CH3: U3.30 (PA6); also elsewhere on the board
unnamed: C18.1, U3.12 (PH0), Y2.1
unnamed: C21.1, U3.48 (VCAP_1)
unnamed: C22.1, U3.13 (PH1), Y2.3
unnamed: C23.1, U3.73 (VCAP_2)
unnamed: D3.1 (K), R15.1
unnamed: D4.1 (K), R16.1
unnamed: J2.1, R19.1, U3.94 (BOOT0)
unnamed: P1.A5 (CC1), R18.2
unnamed: P1.B5 (CC2), R17.2
unnamed: R20.1, U3.14 (NRST)
nRF_CE: U3.56 (PD9); also elsewhere on the board
nRF_CSN: U3.55 (PD8); also elsewhere on the board
nRF_IRQ: U3.57 (PD10); also elsewhere on the board
nRF_MISO: U3.53 (PB14); also elsewhere on the board
nRF_MOSI: U3.54 (PB15); also elsewhere on the board
nRF_SCK: U3.84 (PD3); also elsewhere on the board

Notes on the sheet:
SRAM
CPU

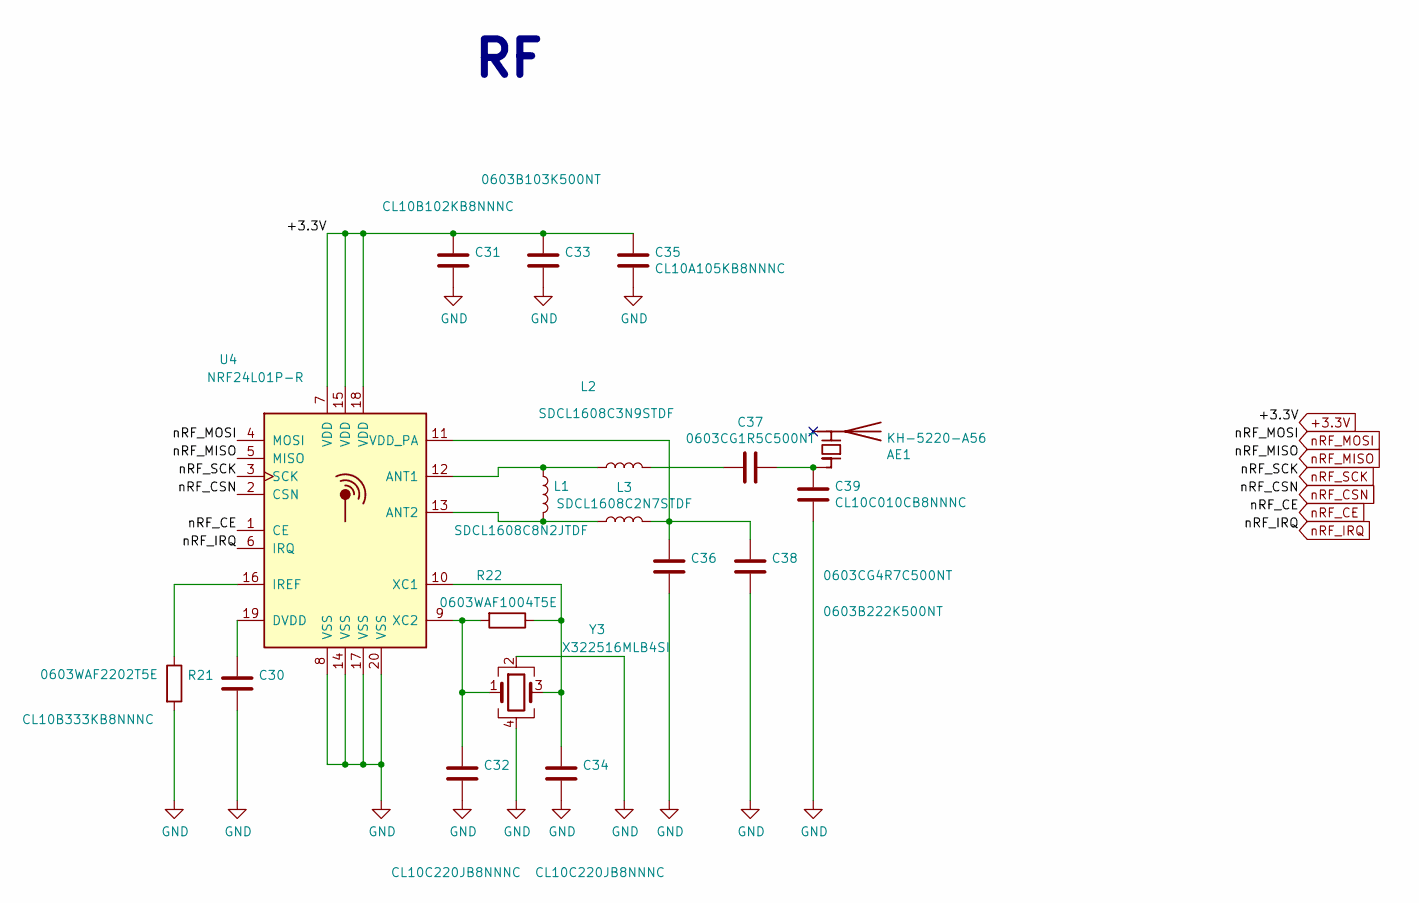
[picture p17: schematic rf.sch]

Parts:
AE1: KH-5220-A56; LCSC C504003
C30: CL10B333KB8NNNC; C_0603_1608Metric; LCSC C21117
C31: CL10B102KB8NNNC; C_0603_1608Metric; LCSC C1588
C32, C34: CL10C220JB8NNNC; C_0603_1608Metric; LCSC C1653
C33: 0603B103K500NT; C_0603_1608Metric; LCSC C57112
C35: CL10A105KB8NNNC; C_0603_1608Metric; LCSC C15849
C36: 0603B222K500NT; C_0603_1608Metric; LCSC C1604
C37: 0603CG1R5C500NT; C_0603_1608Metric; LCSC C1639
C38: 0603CG4R7C500NT; C_0603_1608Metric; LCSC C1669
C39: CL10C010CB8NNNC; C_0603_1608Metric; LCSC C23969
L1: SDCL1608C8N2JTDF; L_0603_1608Metric; LCSC C1032
L2: SDCL1608C3N9STDF; L_0603_1608Metric; LCSC C13818
L3: SDCL1608C2N7STDF; L_0603_1608Metric; LCSC C13817
R21: 0603WAF2202T5E; R_0603_1608Metric; LCSC C31850
R22: 0603WAF1004T5E; R_0603_1608Metric; LCSC C22935
U4: NRF24L01P-R; QFN-20-1EP_4x4mm_P0.5mm_EP2.5x2.5mm; LCSC C8791
Y3: X322516MLB4SI; Crystal_SMD_3225-4Pin_3.2x2.5mm; LCSC C13738

Connections:
+3.3V: C31.1, C33.1, C35.1, U4.7 (VDD), U4.15 (VDD), U4.18 (VDD); also elsewhere on the board
GND: C30.1, C31.2, C32.2, C33.2, C34.2, C35.2, C36.1, C38.1, C39.1, R21.2, U4.8 (VSS), U4.14 (VSS), U4.17 (VSS), U4.20 (VSS), Y3.2, Y3.4; also elsewhere on the board
unnamed: AE1.1 (FEED), C37.1, C39.2
unnamed: C30.2, U4.19 (DVDD)
unnamed: C32.1, R22.2, U4.9 (XC2), Y3.1
unnamed: C34.1, R22.1, U4.10 (XC1), Y3.3
unnamed: C36.2, C38.2, L3.2, U4.11 (VDD_PA)
unnamed: C37.2, L2.2
unnamed: L1.1, L2.1, U4.12 (ANT1)
unnamed: L1.2, L3.1, U4.13 (ANT2)
unnamed: R21.1, U4.16 (IREF)
nRF_CE: U4.1 (CE); also elsewhere on the board
nRF_CSN: U4.2 (CSN); also elsewhere on the board
nRF_IRQ: U4.6 (IRQ); also elsewhere on the board
nRF_MISO: U4.5 (MISO); also elsewhere on the board
nRF_MOSI: U4.4 (MOSI); also elsewhere on the board
nRF_SCK: U4.3 (SCK); also elsewhere on the board

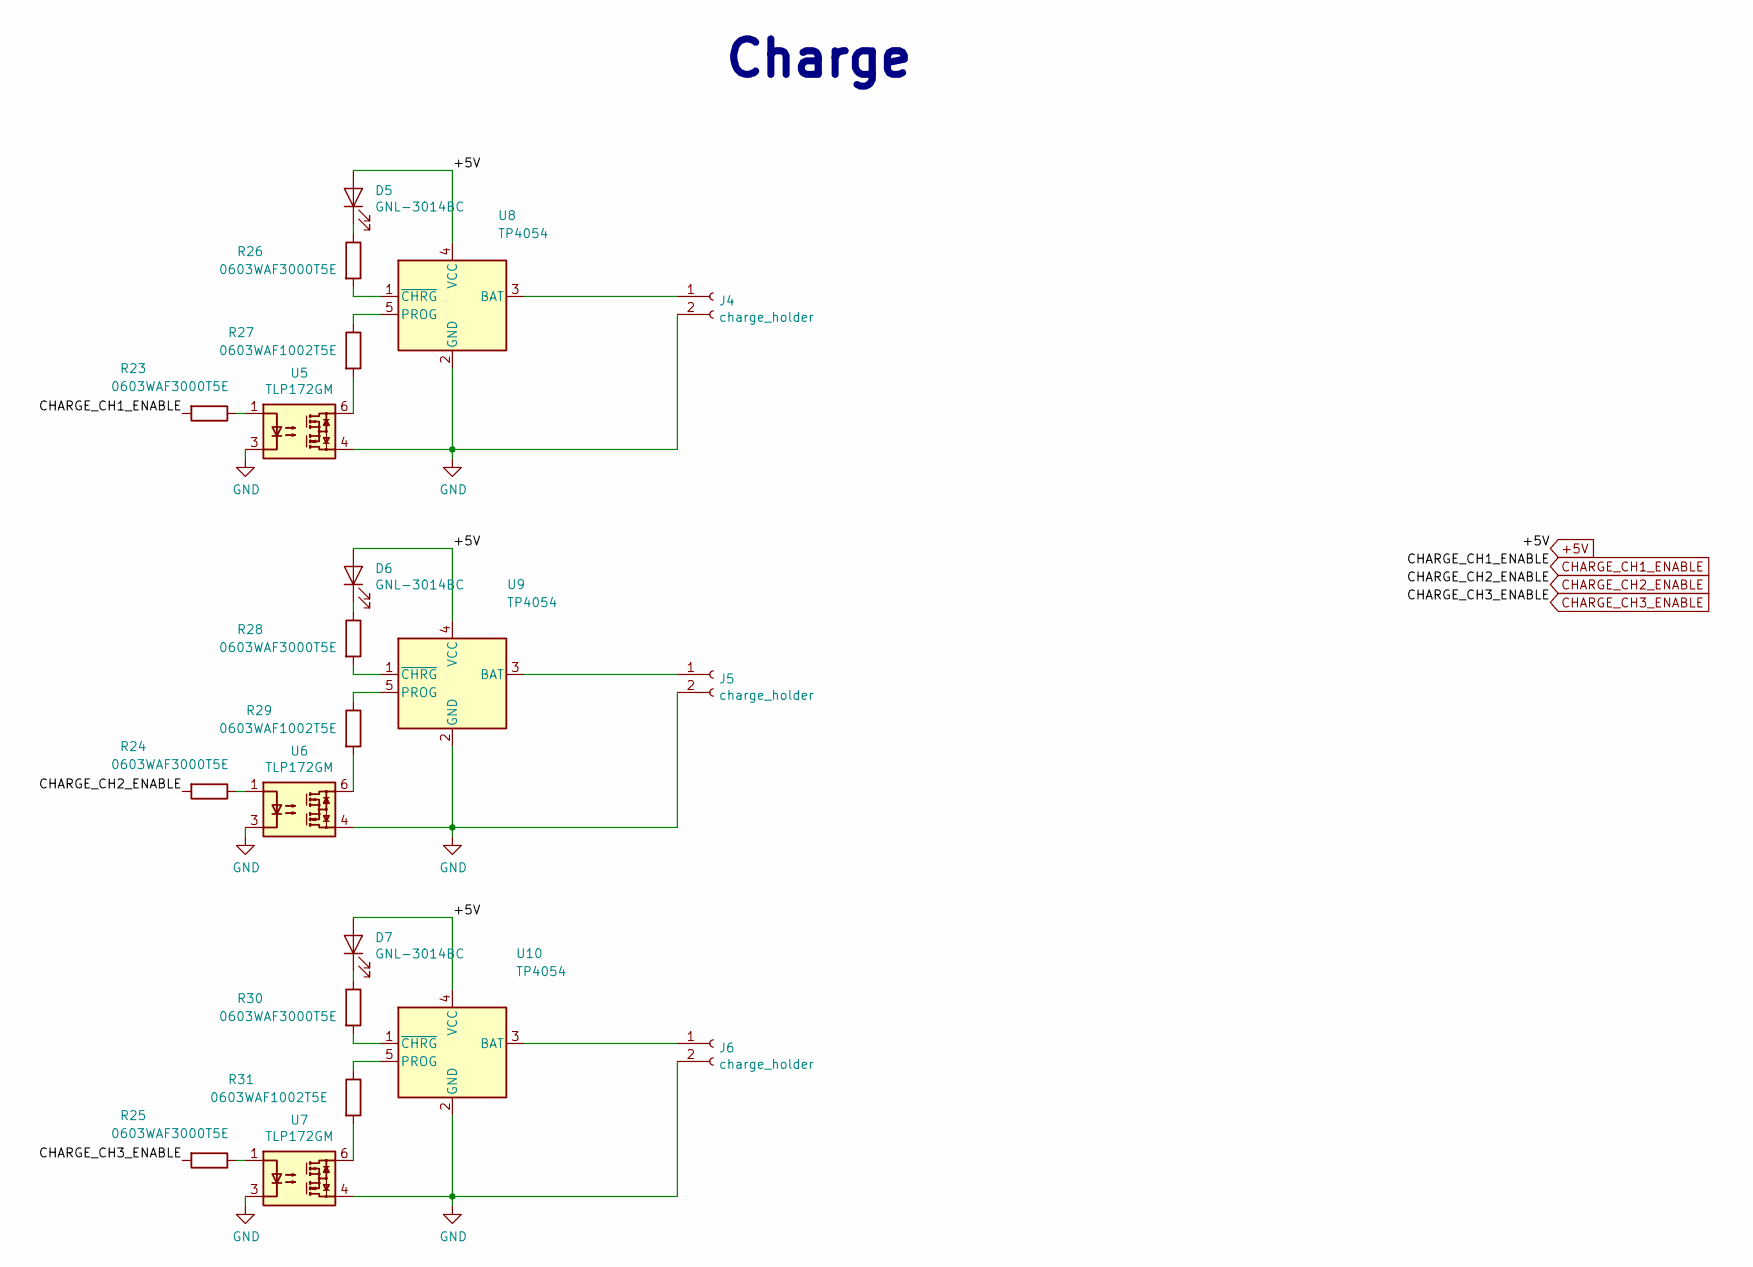
[picture p18: schematic charge.sch]

Parts:
D5, D6, D7: GNL-3014BC; LED_D3.0mm
J4, J5, J6: charge_holder; holder
R23, R24, R25, R26, R28, R30: 0603WAF3000T5E; R_0603_1608Metric; LCSC C23025
R27, R29, R31: 0603WAF1002T5E; R_0603_1608Metric; LCSC C25804
U5, U6, U7: TLP172GM; MFSOP6-4_4.4x3.6mm_P1.27mm; LCSC C261926
U8, U9, U10: TP4054; TSOT-23-5; LCSC C32574

Connections:
+5V: D5.2 (A), D6.2 (A), D7.2 (A), U8.4 (VCC), U9.4 (VCC), U10.4 (VCC); also elsewhere on the board
CHARGE_CH1_ENABLE: R23.2; also elsewhere on the board
CHARGE_CH2_ENABLE: R24.2; also elsewhere on the board
CHARGE_CH3_ENABLE: R25.2; also elsewhere on the board
GND: J4.2, J5.2, J6.2, U5.3, U5.4, U6.3, U6.4, U7.3, U7.4, U8.2 (GND), U9.2 (GND), U10.2 (GND); also elsewhere on the board
unnamed: D5.1 (K), R26.1
unnamed: D6.1 (K), R28.1
unnamed: D7.1 (K), R30.1
unnamed: J4.1, U8.3 (BAT)
unnamed: J5.1, U9.3 (BAT)
unnamed: J6.1, U10.3 (BAT)
unnamed: R23.1, U5.1
unnamed: R24.1, U6.1
unnamed: R25.1, U7.1
unnamed: R26.2, U8.1 (~CHRG)
unnamed: R27.1, U8.5 (PROG)
unnamed: R27.2, U5.6
unnamed: R28.2, U9.1 (~CHRG)
unnamed: R29.1, U9.5 (PROG)
unnamed: R29.2, U6.6
unnamed: R30.2, U10.1 (~CHRG)
unnamed: R31.1, U10.5 (PROG)
unnamed: R31.2, U7.6

Notes on the sheet:
Charge

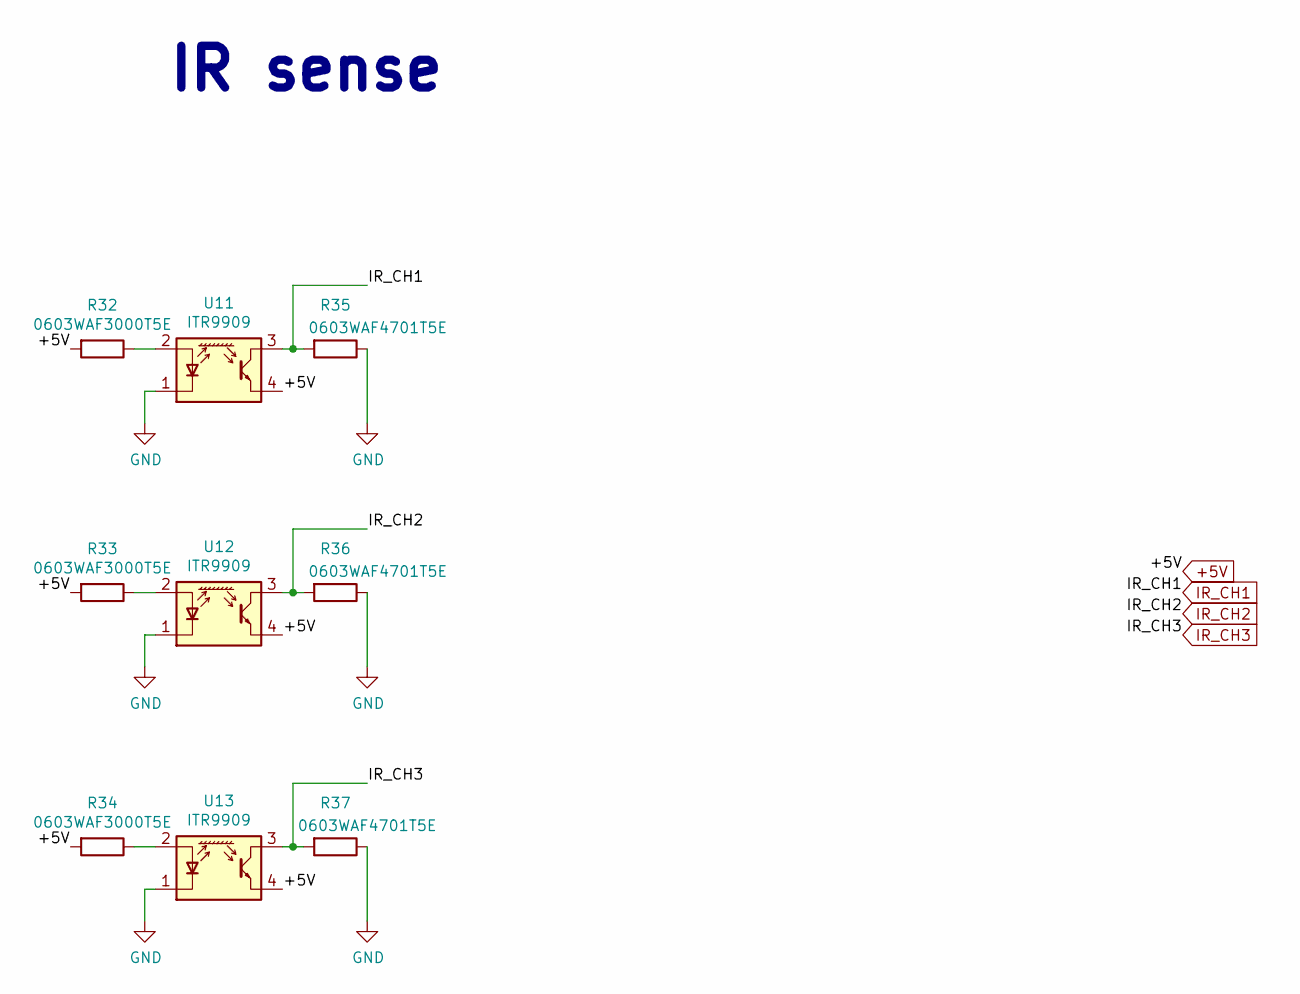
[picture p19: schematic ir_sense.sch]

Parts:
R32, R33, R34: 0603WAF3000T5E; R_0603_1608Metric; LCSC C23025
R35, R36, R37: 0603WAF4701T5E; R_0603_1608Metric; LCSC C23162
U11, U12, U13: ITR9909; ITR9909_ang

Connections:
+5V: R32.2, R33.2, R34.2, U11.4 (E), U12.4 (E), U13.4 (E); also elsewhere on the board
GND: R35.1, R36.1, R37.1, U11.1 (K), U12.1 (K), U13.1 (K); also elsewhere on the board
IR_CH1: R35.2, U11.3 (C); also elsewhere on the board
IR_CH2: R36.2, U12.3 (C); also elsewhere on the board
IR_CH3: R37.2, U13.3 (C); also elsewhere on the board
unnamed: R32.1, U11.2 (A)
unnamed: R33.1, U12.2 (A)
unnamed: R34.1, U13.2 (A)

Notes on the sheet:
IR sense
