Neuropribor/wec/firmware/source_code_for_firmware_STM32CubeIDE/base_station/charge_block/charge_block.kicad_pcb

## KiCad design firmware/source_code_for_firmware_STM32CubeIDE/base_station/charge_block/charge_block.kicad_pcb (continued)

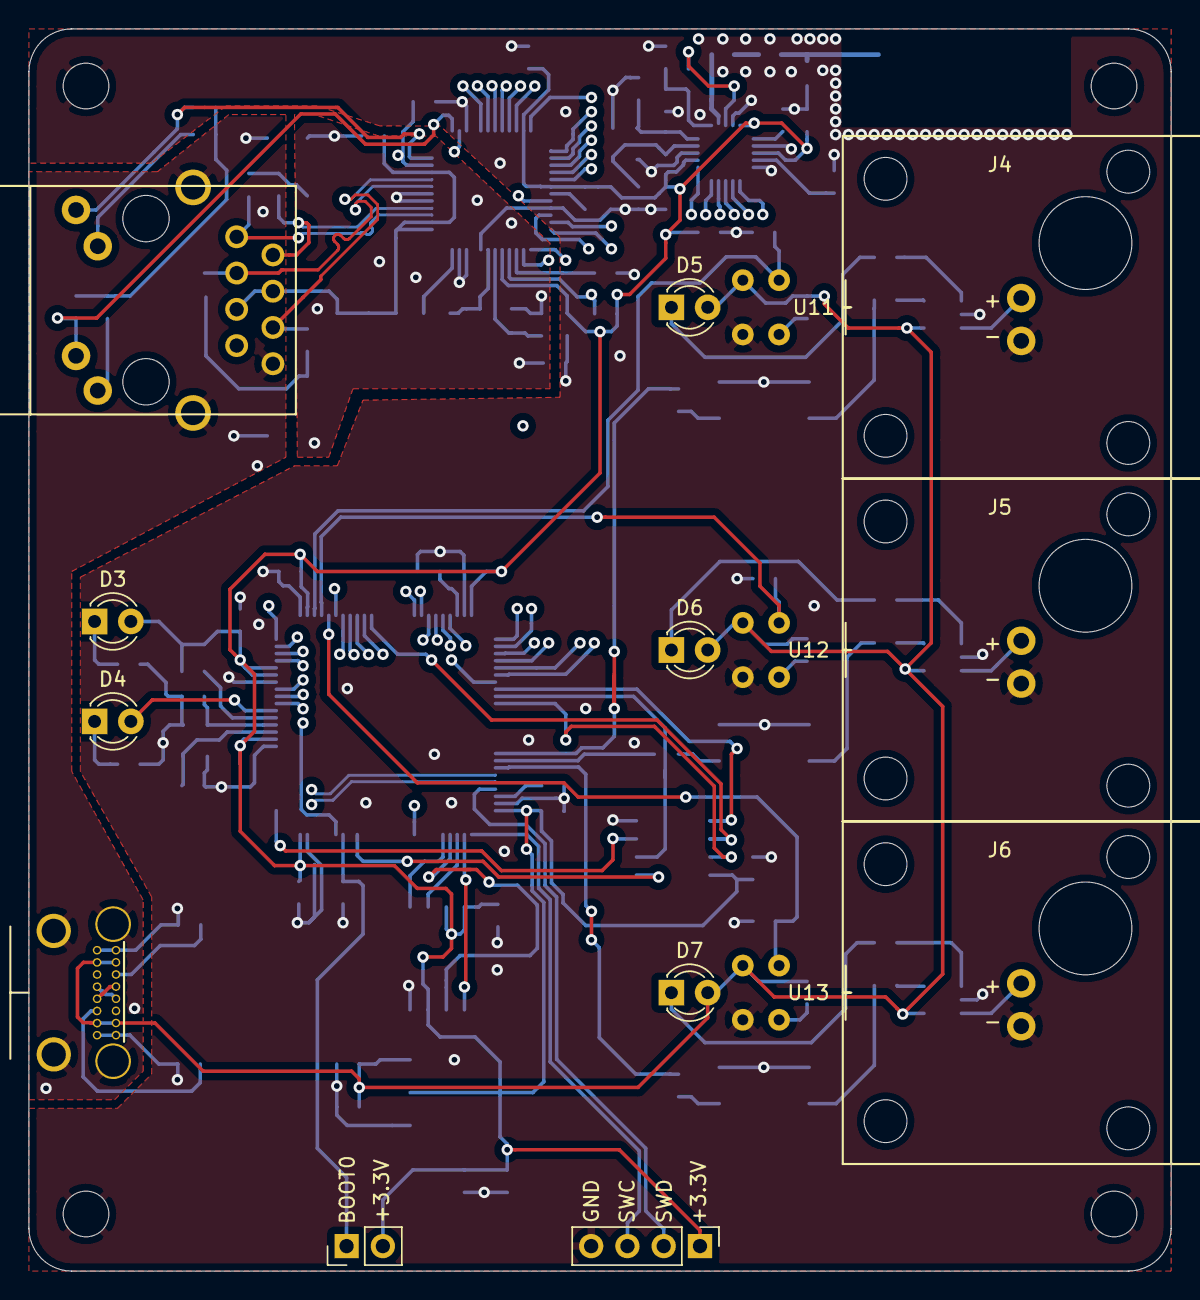
[picture p20: board charge_block.kicad_pcb from above]

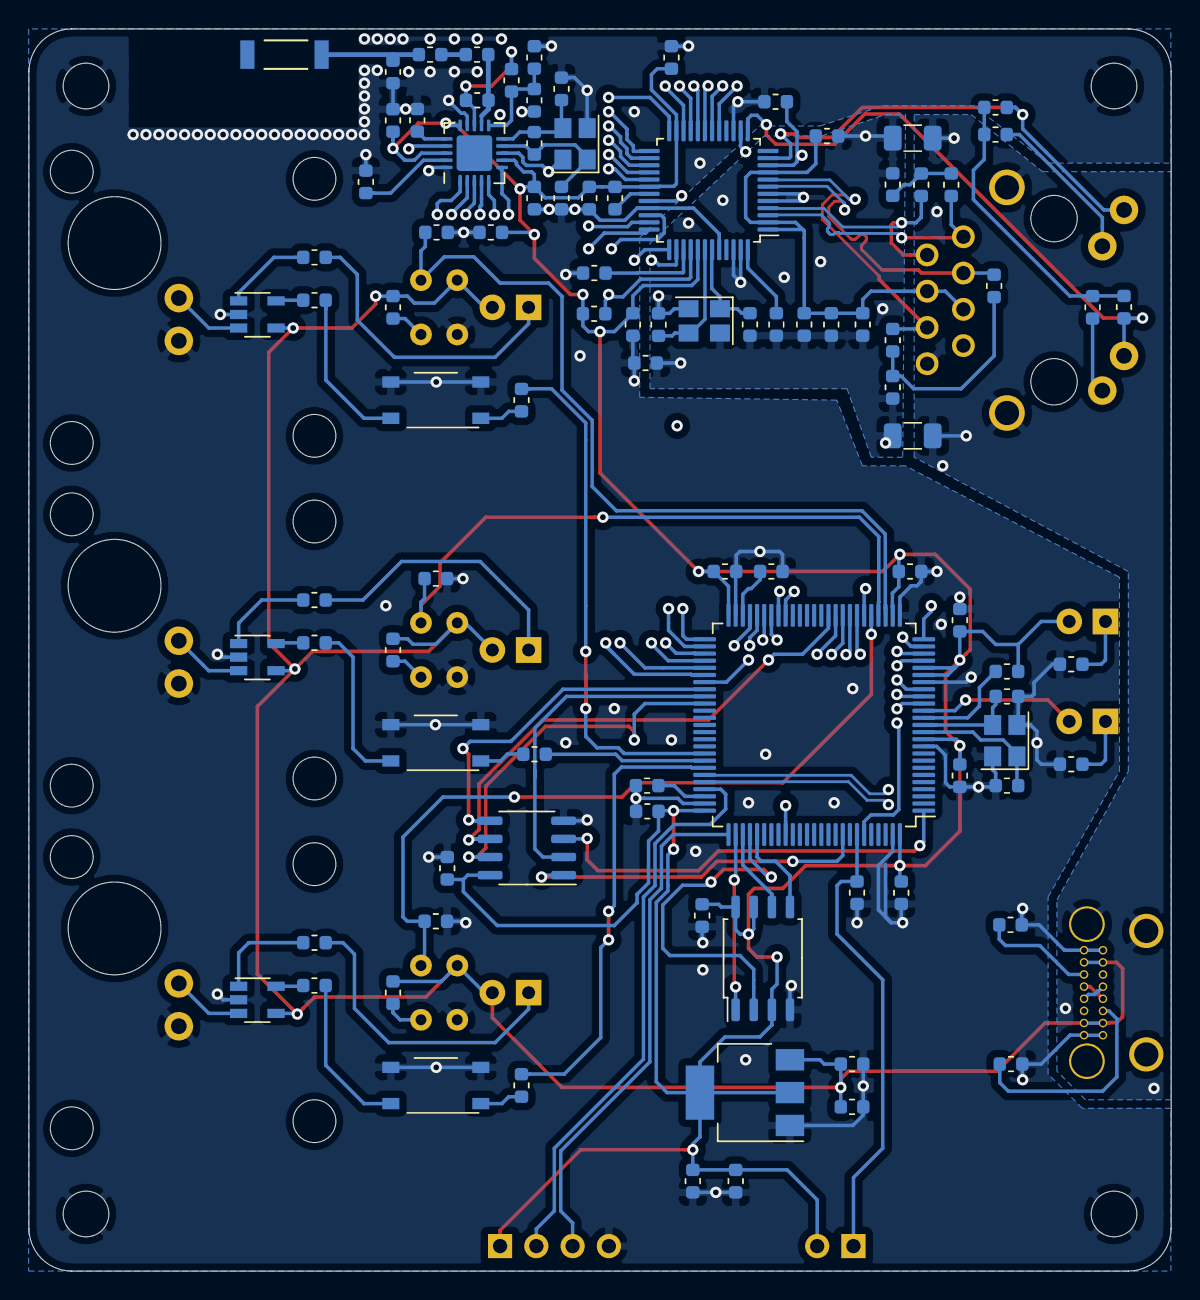
[picture p21: board charge_block.kicad_pcb from below]

Board: 4 copper layers, 80.0 x 87.0 mm, 114 parts (95 on the bottom side), 110 nets.
